aluiziotomazelli/washing-machine/docs/eletrical.webp

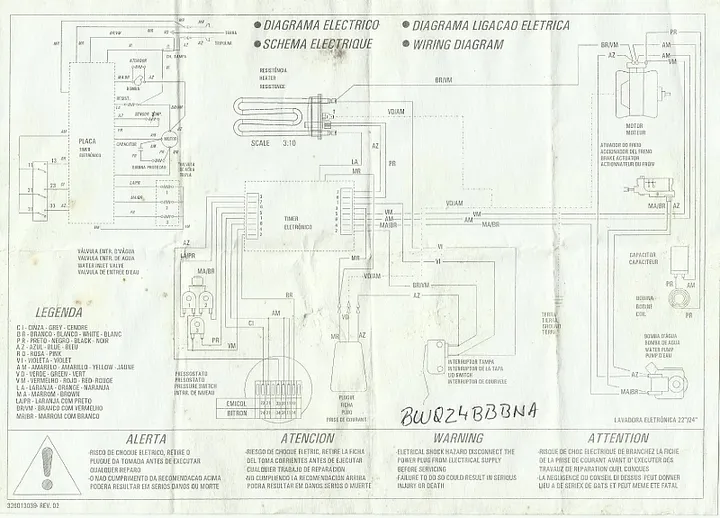
docs/eletrical.webp
