aluiziotomazelli/washing-machine/docs/board-03.webp

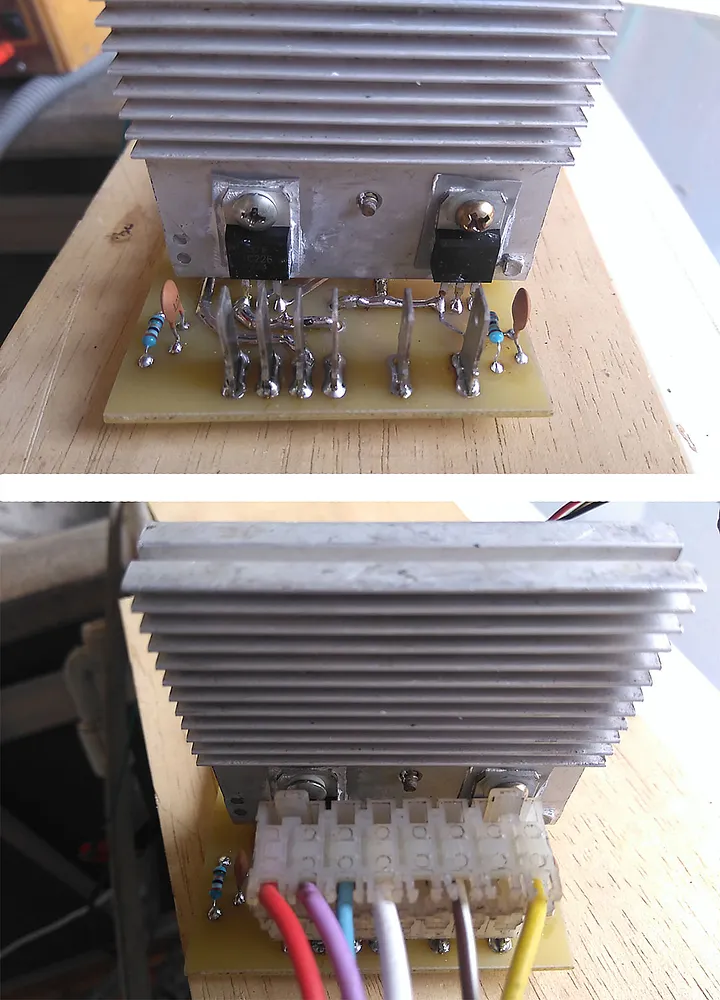
docs/board-03.webp
