aluiziotomazelli/washing-machine/docs/balance_ring_analysis.md

# Hydro-Compensating Balance Ring Dynamic Tuning & Telemetry Analysis

## 1. Executive Summary & Mechanical Context

* **Appliance Under Test:** Brastemp BWQ24B (7 kg capacity top-load domestic washing machine).
* **Firmware:** Clean C++ event-driven controller running on ATmega328P.
* **Telemetry Instrumentation:** MPU-6050 3-axis MEMS accelerometer sampled at 50.0 Hz (20 ms period) on hardware I2C with on-chip 44 Hz DLPF and 200 ms rolling 3D peak-to-peak window processing.
* **Objective:** Empirically diagnose and resolve recurrent spin unbalance aborts (`UNBALANCED_LOAD`) during heavy-fabric washing cycles (e.g. wet denim jeans) by characterizing and restoring the fluid volume of the upper liquid balancer ring.

---

## 2. Problem Statement & Physics of the Balance Ring

### 2.1 The Jeans vs. Blanket Paradox

During initial spin characterization, test runs using a heavy blanket (rolled vertically along the entire drum height) generated moderate vibration without triggering safety trips or cabinet walking. However, real-world washing with wet denim jeans triggered repeated out-of-balance trips during the transition from the final acceleration sprint into high-speed spin.

This discrepancy is governed by the difference between **planar unbalance** and **dynamic conical precession (angular moment)**:

```
   DISTRIBUTED LOAD (BLANKET)                BOTTOM-HEAVY LOAD (JEANS)
      (Planar Centrifugal Force)              (Dynamic Conical Moment)

   ┌────────────────────────┐              ┌────────────────────────┐
   │ [~~~ Balance Ring ~~~] │ ◄─ Direct    │ [~~~ Balance Ring ~~~] │ ◄─ Top counterweight
   │ █                      │    alignment │                        │
   │ █                      │              │                        │    DYNAMIC
   │ █  (Extended mass      │              │       SPIN AXIS        │    CONICAL
   │ █   spans entire       │              │           ▲            │    COUPLE
   │ █   basket height)     │              │           │            │       ↺
   │ █                      │              │  █ █                   │ ◄─ Concentrated
   └──────────┬─────────────┘              └───────────┬────────────┘    mass at bottom
              │                                        │
```

1. **Planar Centrifugal Force:**
   $$F_c = m \cdot \omega^2 \cdot r$$
   When the load spans the full height of the basket, its center of mass sits near the upper rim. The liquid balance ring sits directly in this plane, allowing fluid to shift to the opposite wall and cancel the radial force.

2. **Conical Precession Couple (Moment Arm $d$):**
   $$M = F_c \times d = (m \cdot \omega^2 \cdot r) \cdot d$$
   Wet jeans compact into a dense, rigid lump at the bottom of the basket, far below the suspension pivot and the balance ring. The bottom-heavy mass exerts a tilting torque on the hanging suspension rods. If the balance ring lacks adequate fluid volume, the upper counter-torque cannot cancel the bottom moment, causing severe resonant wobble during acceleration.

### 2.2 Balance Ring Fluid Mechanics & Evaporation

The liquid balancer ring on top-load washers is a hollow annular polypropylene channel containing internal baffle chambers and a saline/water solution. Its operating principle relies on **supercritical rotation** ($\omega > \omega_n$, where $\omega_n \approx 150\text{--}250\text{ RPM}$ is the suspension natural frequency):

* Below resonance ($\omega < \omega_n$), the fluid leads the unbalance.
* Above resonance ($\omega > \omega_n$), phase lag shifts the fluid $180^\circ$ out-of-phase, directly opposing the eccentric mass.
* The internal baffles force fluid through restrictive apertures, dissipating kinetic energy as viscous shear heat.

Over 10 to 15+ years of service, micro-permeation through the polymer walls and weld joints gradually reduces fluid mass. If fluid volume drops below $\sim 40\%$, the ring cannot generate sufficient counter-torque ($m_{\text{fluid}} \cdot r \cdot \omega^2$) to stabilize heavy bottom unbalances.

Conversely, overfilling starves the ring of the void space required for fluid to concentrate entirely on the opposite side, forcing excess fluid to co-rotate on the heavy side.

---

## 3. Experimental Methodology

1. **Mechanical Preparation & Initial Volume State:**
   * A service port was drilled in the upper face of the balance ring.
   * **Baseline Fluid Level:** The absolute initial fluid volume could not be drained and weighed directly because removing the ring would require complete mechanical disassembly of the wash basket, hub, and drive transmission. However, visual and physical inspection through the drilled port confirmed that the initial resting fluid level was **below 50% of the internal ring height**.
   * Sealed incrementally using an M-threaded screw with an elastomeric O-ring.
   * A fixed eccentric test load (dry mass secured to one quadrant of the basket) was maintained across all iterations to guarantee identical initial conditions.

2. **Sprint & Cruise Firmware Profile Tuning:**
   The `SprintStep` progressive profile was revised from longer durations to tighter, shorter acceleration pulses to improve initial distribution and smooth resonance crossing:

   * **Previous Default Profile:**
     * `Sprint 1:` `{4000, 3500}` (4.0s ON / 3.5s OFF)
     * `Sprint 2:` `{5000, 3500}` (5.0s ON / 3.5s OFF)
     * `Sprint 3:` `{6000, 4000}` (6.0s ON / 4.0s OFF)
     * `Sprint 4:` `{7000, 3000}` (7.0s ON / 3.0s OFF)
   * **Tuned Balance-Ring Profile (Active):**
     * `Sprint 1:` `{3000, 2000}` (3.0s ON / 2.0s OFF)
     * `Sprint 2:` `{3500, 2500}` (3.5s ON / 2.5s OFF)
     * `Sprint 3:` `{4000, 3500}` (4.0s ON / 3.5s OFF)
     * `Sprint 4:` `{4500, 4000}` (4.5s ON / 4.0s OFF)

   * **Full Recipe Timeline:**
     * **Clutch Engagement:** $0.0\text{s} \to 5.0\text{s}$ (5.0s pump pre-drain)
     * **Sprint 1:** $5.0\text{s} \to 8.0\text{s}$ (3.0s ON) / $8.0\text{s} \to 10.0\text{s}$ (2.0s OFF)
     * **Sprint 2:** $10.0\text{s} \to 13.5\text{s}$ (3.5s ON) / $13.5\text{s} \to 16.0\text{s}$ (2.5s OFF)
     * **Sprint 3:** $16.0\text{s} \to 20.0\text{s}$ (4.0s ON) / $20.0\text{s} \to 23.5\text{s}$ (3.5s OFF)
     * **Sprint 4 (Resonance Transition):** $23.5\text{s} \to 28.0\text{s}$ (4.5s ON) / $28.0\text{s} \to 32.0\text{s}$ (4.0s OFF)
     * **Duty Cruise (High Speed):** $32.0\text{s} \to 60.0\text{s}$ (4.0s ON / 4.0s OFF periodic pulses)

3. **Telemetry Acquisition:**
   * Python recording script: [`scripts/record_telemetry.py`](../scripts/record_telemetry.py)
   * Log repository: [`logs/balance-ring/`](../logs/balance-ring/)
   * Metric: $\text{Vib} = \Delta X + \Delta Y + \Delta Z$ (LSB over 200 ms window).

---

## 4. Telemetry Datasets & Results

Eight comprehensive 50 Hz telemetry runs were recorded and archived in `logs/balance-ring/`:

| Log File | Injected Fluid | Total Samples | Mean Vibration | Peak Shock Vibration | Resonance Peak (S4 OFF) | Cruise Mean (40–60s) |
| :--- | :---: | :---: | :---: | :---: | :---: | :---: |
| [`test_00_base.csv`](../logs/balance-ring/test_00_base.csv) | **+0 mL (Base)** | 3,002 | **3,783.9 LSB** | **29,429 LSB** | **27,742 LSB** | 3,387.0 LSB |
| [`test_01_plus50ml.csv`](../logs/balance-ring/test_01_plus50ml.csv) | **+50 mL** | 3,003 | **3,076.7 LSB** | **21,983 LSB** | **9,519 LSB** | 5,050.3 LSB |
| [`test_02_plus100ml.csv`](../logs/balance-ring/test_02_plus100ml.csv) | **+100 mL** | 3,003 | **2,933.8 LSB** | **8,309 LSB** | **5,436 LSB** | 5,250.2 LSB |
| [`test_03_plus150ml.csv`](../logs/balance-ring/test_03_plus150ml.csv) | **+150 mL** | 3,002 | **2,791.9 LSB** | **8,549 LSB** | **4,376 LSB** | 5,340.1 LSB |
| [`test_04_plus200ml.csv`](../logs/balance-ring/test_04_plus200ml.csv) | **+200 mL** | 3,002 | **2,444.0 LSB** | **6,116 LSB** | **4,132 LSB** | 4,057.2 LSB |
| [`test_05_plus250ml.csv`](../logs/balance-ring/test_05_plus250ml.csv) | **+250 mL** | 3,003 | 🏆 **2,140.2 LSB** | 🏆 **5,080 LSB** | 🏆 **3,485 LSB** | 🏆 **3,774.2 LSB** |
| [`test_06_plus300ml.csv`](../logs/balance-ring/test_06_plus300ml.csv) | **+300 mL** | 3,003 | 2,069.7 LSB | 📈 **5,901 LSB** | 3,043 LSB | 📈 **4,177.3 LSB** |
| [`test_07_almost-balanced-load_plus250ml.csv`](../logs/balance-ring/test_07_almost-balanced-load_plus250ml.csv) | **+250 mL (Real Load)** | 2,651 | 🏆 **1,123.4 LSB** | 🏆 **3,884 LSB** | 🏆 **1,486 LSB** | 🏆 **2,623.1 LSB** |

---

## 5. Phase-by-Phase Comparative Breakdown

The table below details mean vibration across each discrete phase of the spin recipe from baseline to overfill:

| Recipe Phase | Time Window | Base (+0 mL) | +100 mL | +150 mL | +200 mL | +250 mL (Optimal) | +300 mL (Overfill) |
| :--- | :---: | :---: | :---: | :---: | :---: | :---: | :---: |
| **Clutch Delay** | 0.0s – 5.0s | 121.7 LSB | 159.6 LSB | 149.5 LSB | 159.7 LSB | **168.8 LSB** | 214.4 LSB |
| **Sprint 1 ON (3.0s)** | 5.0s – 8.0s | 131.1 LSB | 268.4 LSB | 270.9 LSB | 900.6 LSB | **274.1 LSB** | 216.8 LSB |
| **Sprint 1 OFF (2.0s)** | 8.0s – 10.0s | 192.8 LSB | 309.5 LSB | 351.8 LSB | 1250.2 LSB | **382.4 LSB** | 375.3 LSB |
| **Sprint 2 ON (3.5s)** | 10.0s – 13.5s | 268.2 LSB | 316.6 LSB | 302.3 LSB | 544.4 LSB | **295.9 LSB** | 236.6 LSB |
| **Sprint 2 OFF (2.5s)** | 13.5s – 16.0s | 342.9 LSB | 448.3 LSB | 375.9 LSB | 513.0 LSB | **410.0 LSB** | 417.8 LSB |
| **Sprint 3 ON (4.0s)** | 16.0s – 20.0s | 366.0 LSB | 1,827.4 LSB | 1,882.9 LSB | 1,795.8 LSB | **1,538.3 LSB** | 1,229.8 LSB |
| **Sprint 3 OFF (3.5s)** | 20.0s – 23.5s | 677.7 LSB | 1,819.3 LSB | 1,934.5 LSB | 1,947.9 LSB | **1,762.7 LSB** | 1,809.4 LSB |
| **Sprint 4 ON (4.5s)** | 23.5s – 28.0s | 3,351.9 LSB | 1,165.3 LSB | 823.1 LSB | 893.3 LSB | **757.8 LSB** | 692.4 LSB |
| **Sprint 4 OFF (Resonance)** | 28.0s – 32.0s | **15,446.2 LSB** | **3,288.9 LSB** | **1,985.5 LSB** | **2,824.9 LSB** | **2,062.1 LSB** | 1,730.9 LSB |
| **Cruise 1 ON (4.0s)** | 32.0s – 36.0s | **10,837.2 LSB** | 3,000.8 LSB | 3,494.0 LSB | 2,327.1 LSB | **2,779.3 LSB** | 1,499.0 LSB |
| **Cruise 1 OFF (4.0s)** | 36.0s – 40.0s | **8,039.3 LSB** | 5,629.7 LSB | 4,106.2 LSB | 4,410.8 LSB | **3,328.2 LSB** | 3,535.9 LSB |
| **Cruise 2 ON (4.0s)** | 40.0s – 44.0s | 2,341.5 LSB | 4,339.9 LSB | 5,429.7 LSB | 3,389.0 LSB | **3,558.5 LSB** | 3,438.0 LSB |
| **Cruise 2 OFF (4.0s)** | 44.0s – 48.0s | 1,484.0 LSB | 6,360.9 LSB | 4,953.8 LSB | 4,909.8 LSB | **3,818.8 LSB** | 4,200.5 LSB |
| **Cruise 3 ON (4.0s)** | 48.0s – 52.0s | 2,544.4 LSB | 4,474.6 LSB | 5,508.5 LSB | 3,505.9 LSB | **3,695.8 LSB** | 3,624.5 LSB |
| **Cruise 3 OFF (4.0s)** | 52.0s – 56.0s | 5,179.7 LSB | 6,446.0 LSB | 5,144.3 LSB | 4,959.5 LSB | **3,927.7 LSB** | **4,605.7 LSB** |
| **Cruise 4 ON (4.0s)** | 56.0s – 60.0s | 5,389.1 LSB | 4,624.4 LSB | 5,685.8 LSB | 3,520.8 LSB | **3,881.8 LSB** | **3,749.5 LSB** |

---

## 6. Key Analysis & The Convex Inflection Point

```
 Peak Vibration vs. Injected Fluid Volume (Convex U-Curve)

  30k ──┐  Base (29,429 LSB)
        │   █
  25k ──┼───█─────────────────────────────────────── Critical Trip Limit (11,000 LSB)
        │   █     +50mL (21,983 LSB)
  20k ──┼───█──────█────────────────────────────────
        │   █      █
  15k ──┼───█──────█────────────────────────────────
        │   █      █
  10k ──┼───█──────█──────+100mL     +150mL
        │   █      █      (8,309)   (8,549)             +300mL (5,901)
   5k ──┼───█──────█────────█─────────█───────+200mL      ▲ (Uptick)
        │   █      █        █         █       (6,116)  +250mL █
    0 ──┴───┴──────┴────────┴─────────┴─────────█─────────█───┴────
          +0mL   +50mL   +100mL    +150mL    +200mL   +250mL +300mL
                                             [--- SWEET SPOT ---]
```

1. **Baseline Failure (0 mL):**
   * The depleted balance ring generated a peak shock of **29,429 LSB** (nearly $3\times$ the firmware safety trip threshold of 11,000 LSB).
   * Sustained resonance oscillation during Sprint 4 OFF and Cruise 1 lasted over 12 seconds with average vibration exceeding 15,000 LSB.

2. **Linear Recovery Zone (+50 mL to +150 mL):**
   * **+50 mL:** Reduced peak shock to 21,983 LSB (-25.3%). Rapid damping appeared immediately upon motor de-energization.
   * **+100 mL:** Peak dropped to 8,309 LSB (-71.8%). For the first time, vibration remained below the firmware warning threshold (8,500 LSB) throughout the entire run.
   * **+150 mL:** Resonance peak in Sprint 4 OFF dropped from 15,446 LSB down to 1,985 LSB (-87.1%).

3. **Optimal Minimum (+200 mL to +250 mL):**
   * **+200 mL:** Global peak dropped to 6,116 LSB; steady-state cruise dropped to 4,057 LSB.
   * **+250 mL (Global Minimum):** Achieved the lowest peak shock across the entire experiment at **5,080 LSB** (-82.7% reduction vs. baseline) and the lowest overall average at **2,140.2 LSB**.

4. **Inflection / Overfill Zone (+300 mL):**
   * At +300 mL, peak vibration reversed direction and climbed back up to **5,901 LSB** (+16.2% increase vs. +250 mL).
   * High-speed cruise vibration (52s–60s) rose from 3,927 LSB to 4,605 LSB due to fluid co-rotation on the eccentric quadrant.

---

## 7. Real-World Distributed Load Verification (`test_07`)

Following the identification of the +250 mL optimum, the balance ring was sealed with an M-screw and elastomeric O-ring. A realistic asymmetric load (~750g on one basket side vs. ~500g on the opposite side, net unbalance ~250g) was tested:

| Metric | Baseline (+0 mL, Unbalanced) | Test 05 (+250 mL, Single-Sided) | **Test 07 (+250 mL, Distributed Load)** | **Empty Tub Reference** |
| :--- | :---: | :---: | :---: | :---: |
| **Peak Shock Vibration** | 29,429 LSB | 5,080 LSB | 🏆 **3,884 LSB** | **3,729 LSB** |
| **Mean Vibration (0–60s)** | 3,783.9 LSB | 2,140.2 LSB | 🏆 **1,123.4 LSB** | **1,365.6 LSB** |
| **Sprint 4 Resonance Peak** | 27,742 LSB | 3,485 LSB | 🏆 **1,486 LSB** | — |
| **Cruise Steady-State Mean** | 3,387.0 LSB | 3,774.2 LSB | 🏆 **2,623.1 LSB** | — |

* **Key Result:** Under real washing conditions with +250 mL injected, the machine exhibited an overall mean vibration of **1,123.4 LSB** and a peak of **3,884 LSB**, performing virtually identically to an empty drum (1,365.6 LSB mean / 3,729 LSB peak).
* **Safety Margin:** Operating at 3,884 LSB provides a **$\approx 280\%$ safety margin** below the 11,000 LSB firmware trip threshold, eliminating spurious unbalance trips.

---

## 8. Physical Calibration Reference (Brastemp BWQ24B)

* **Calibrated Added Volume:** **+250 mL** (via syringe injection).
* **Internal Water Level:** Direct inspection confirmed that with the +250 mL replenishment, the resting water column occupies approximately **75% of the total internal height** of the annular ring channel.
* **Hermetic Seal:** Mechanical sealing completed using an M-threaded screw with an elastomeric O-ring.
* **Firmware Configuration:** Out-of-balance trip threshold safely maintained at **11,000 LSB** (sustained $\ge 1.0\text{s}$) / **14,000 LSB** (immediate shock), ensuring complete reliability under heavy residential wash loads without nuisance trips.
