aluiziotomazelli/washing-machine/docs/board-01.webp

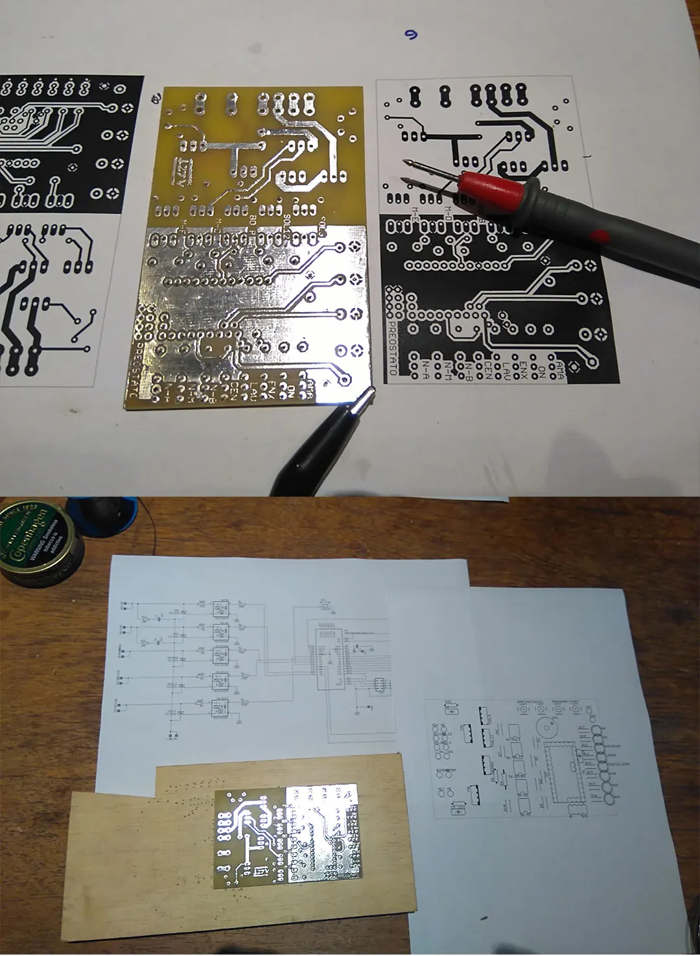
docs/board-01.webp
