aluiziotomazelli/washing-machine/docs/board-02.webp

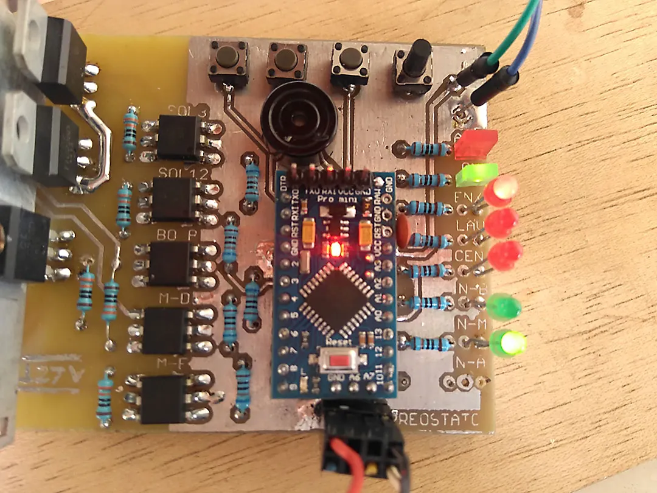
docs/board-02.webp
