aluiziotomazelli/washing-machine/docs/board-04.webp

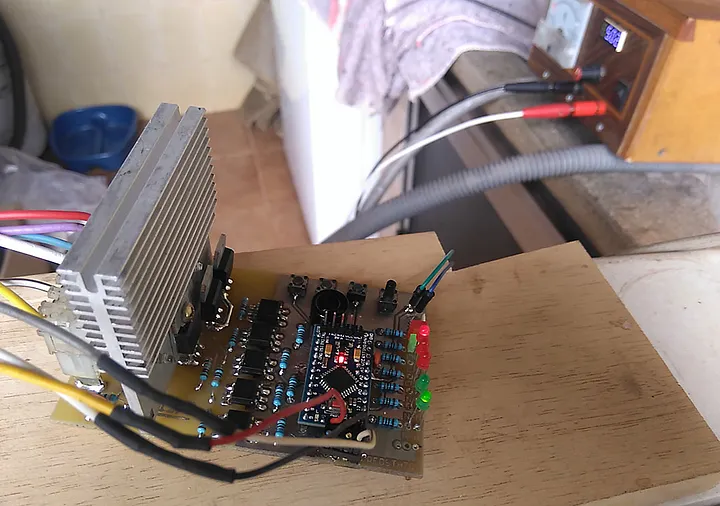
docs/board-04.webp
