aluiziotomazelli/washing-machine/docs/box.webp

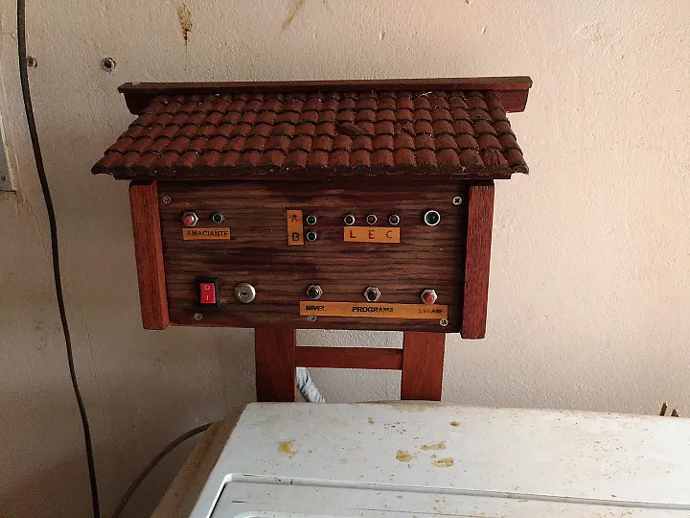
docs/box.webp
