aluiziotomazelli/washing-machine/docs/pressostat.webp

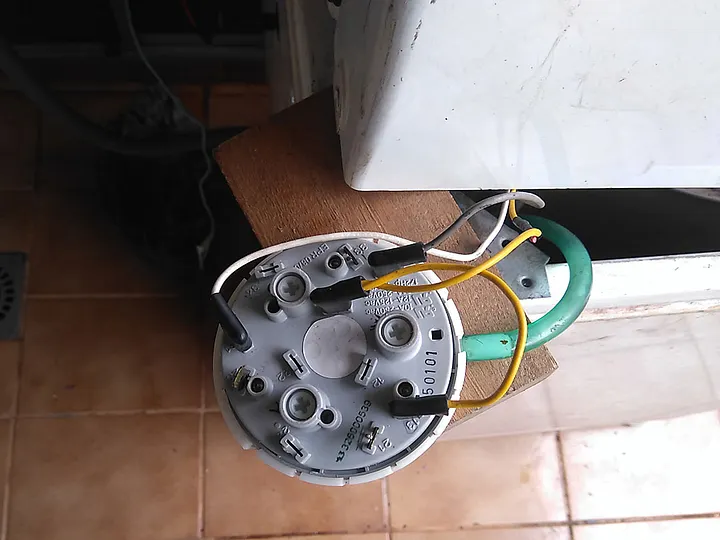
docs/pressostat.webp
