aluiziotomazelli/washing-machine/docs/schematic-01.webp

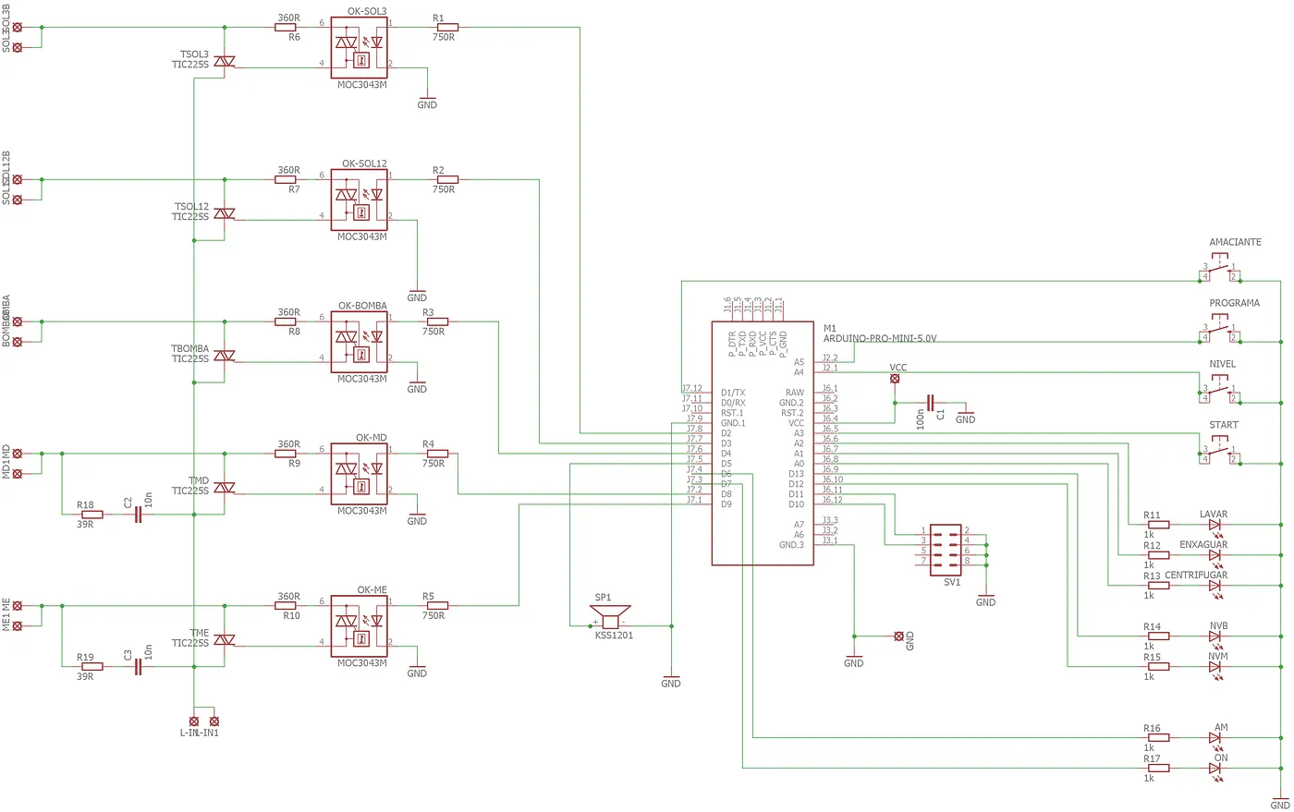
docs/schematic-01.webp
