aluiziotomazelli/washing-machine/logs/balance-ring/test_00_base.csv

elapsed_ms | elapsed_s | x | y | z | vib
0 | 0.000 | -7526 | -377 | -1177 | 0
16 | 0.016 | -7519 | -394 | -1208 | 0
47 | 0.048 | -7515 | -392 | -1182 | 0
63 | 0.064 | -7542 | -377 | -1195 | 0
79 | 0.080 | -7532 | -383 | -1185 | 0
95 | 0.096 | -7548 | -393 | -1177 | 0
127 | 0.128 | -7553 | -373 | -1174 | 0
143 | 0.144 | -7513 | -402 | -1199 | 0
159 | 0.160 | -7523 | -383 | -1161 | 0
175 | 0.176 | -7537 | -377 | -1163 | 116
207 | 0.208 | -7511 | -398 | -1164 | 116
223 | 0.223 | -7511 | -374 | -1213 | 116
239 | 0.239 | -7533 | -371 | -1189 | 116
255 | 0.255 | -7516 | -374 | -1178 | 116
287 | 0.287 | -7516 | -386 | -1183 | 116
303 | 0.303 | -7527 | -400 | -1211 | 116
319 | 0.319 | -7510 | -388 | -1172 | 116
335 | 0.335 | -7549 | -381 | -1167 | 116
367 | 0.367 | -7536 | -373 | -1200 | 116
382 | 0.383 | -7527 | -360 | -1180 | 128
398 | 0.398 | -7504 | -378 | -1168 | 128
414 | 0.415 | -7517 | -396 | -1213 | 128
446 | 0.447 | -7519 | -382 | -1193 | 128
462 | 0.463 | -7542 | -373 | -1199 | 128
478 | 0.479 | -7526 | -375 | -1211 | 128
494 | 0.495 | -7534 | -398 | -1240 | 128
526 | 0.526 | -7526 | -393 | -1204 | 128
541 | 0.542 | -7516 | -378 | -1182 | 128
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
