aluiziotomazelli/washing-machine/logs/balance-ring/test_01_plus50ml.csv

elapsed_ms | elapsed_s | x | y | z | vib
0 | 0.000 | -7549 | -375 | -1181 | 0
15 | 0.016 | -7514 | -370 | -1181 | 0
31 | 0.032 | -7526 | -379 | -1184 | 0
63 | 0.064 | -7519 | -384 | -1193 | 0
79 | 0.080 | -7520 | -372 | -1207 | 0
95 | 0.096 | -7522 | -391 | -1200 | 0
111 | 0.112 | -7546 | -381 | -1207 | 0
143 | 0.143 | -7517 | -370 | -1195 | 0
159 | 0.159 | -7517 | -367 | -1183 | 0
175 | 0.175 | -7531 | -369 | -1182 | 85
191 | 0.191 | -7501 | -366 | -1200 | 85
223 | 0.223 | -7522 | -367 | -1221 | 85
239 | 0.239 | -7516 | -377 | -1223 | 85
255 | 0.255 | -7546 | -365 | -1190 | 85
271 | 0.271 | -7552 | -386 | -1203 | 85
302 | 0.303 | -7505 | -361 | -1204 | 85
318 | 0.319 | -7508 | -389 | -1202 | 85
334 | 0.335 | -7514 | -364 | -1201 | 85
366 | 0.366 | -7520 | -362 | -1211 | 85
382 | 0.383 | -7563 | -396 | -1175 | 145
398 | 0.399 | -7533 | -372 | -1154 | 145
414 | 0.415 | -7531 | -364 | -1173 | 145
446 | 0.446 | -7510 | -375 | -1186 | 145
462 | 0.462 | -7531 | -362 | -1210 | 145
478 | 0.478 | -7533 | -372 | -1190 | 145
494 | 0.494 | -7531 | -349 | -1198 | 145
525 | 0.526 | -7540 | -386 | -1185 | 145
542 | 0.542 | -7522 | -377 | -1185 | 145
558 | 0.558 | -7503 | -350 | -1195 | 145
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
