aluiziotomazelli/washing-machine/logs/balance-ring/test_02_plus100ml.csv

elapsed_ms | elapsed_s | x | y | z | vib
0 | 0.000 | -7522 | -398 | -1192 | 0
15 | 0.016 | -7525 | -379 | -1191 | 0
31 | 0.032 | -7535 | -391 | -1175 | 0
63 | 0.063 | -7512 | -386 | -1190 | 0
79 | 0.080 | -7533 | -369 | -1175 | 0
95 | 0.096 | -7527 | -365 | -1224 | 0
111 | 0.112 | -7521 | -396 | -1202 | 0
142 | 0.143 | -7510 | -392 | -1227 | 0
158 | 0.159 | -7527 | -392 | -1199 | 0
175 | 0.175 | -7525 | -373 | -1195 | 110
191 | 0.191 | -7516 | -380 | -1169 | 110
223 | 0.223 | -7528 | -364 | -1179 | 110
239 | 0.239 | -7512 | -396 | -1197 | 110
255 | 0.255 | -7520 | -386 | -1220 | 110
271 | 0.271 | -7516 | -365 | -1191 | 110
302 | 0.303 | -7503 | -374 | -1206 | 110
318 | 0.319 | -7539 | -391 | -1217 | 110
334 | 0.335 | -7507 | -362 | -1199 | 110
350 | 0.351 | -7512 | -383 | -1184 | 110
382 | 0.383 | -7527 | -396 | -1202 | 121
398 | 0.399 | -7535 | -375 | -1210 | 121
414 | 0.415 | -7519 | -374 | -1217 | 121
430 | 0.431 | -7502 | -384 | -1172 | 121
462 | 0.462 | -7531 | -398 | -1201 | 121
478 | 0.478 | -7524 | -372 | -1190 | 121
494 | 0.494 | -7525 | -395 | -1183 | 121
510 | 0.510 | -7531 | -360 | -1207 | 121
542 | 0.542 | -7498 | -368 | -1191 | 121
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
