aluiziotomazelli/washing-machine/logs/balance-ring/test_03_plus150ml.csv

elapsed_ms | elapsed_s | x | y | z | vib
0 | 0.000 | -7532 | -374 | -1195 | 0
31 | 0.032 | -7528 | -375 | -1223 | 0
47 | 0.048 | -7521 | -372 | -1195 | 0
63 | 0.064 | -7524 | -391 | -1218 | 0
79 | 0.080 | -7506 | -393 | -1174 | 0
111 | 0.111 | -7509 | -383 | -1239 | 0
127 | 0.127 | -7535 | -366 | -1206 | 0
143 | 0.143 | -7550 | -369 | -1162 | 0
159 | 0.159 | -7528 | -394 | -1176 | 0
191 | 0.191 | -7540 | -392 | -1168 | 149
207 | 0.207 | -7520 | -383 | -1187 | 149
223 | 0.223 | -7518 | -370 | -1228 | 149
239 | 0.239 | -7527 | -360 | -1209 | 149
271 | 0.271 | -7495 | -388 | -1168 | 149
287 | 0.287 | -7526 | -363 | -1211 | 149
302 | 0.303 | -7509 | -380 | -1243 | 149
318 | 0.319 | -7537 | -390 | -1227 | 149
350 | 0.351 | -7520 | -386 | -1202 | 149
366 | 0.367 | -7502 | -382 | -1177 | 149
382 | 0.383 | -7499 | -352 | -1189 | 155
398 | 0.399 | -7529 | -368 | -1166 | 155
430 | 0.431 | -7532 | -400 | -1192 | 155
446 | 0.446 | -7514 | -361 | -1186 | 155
462 | 0.462 | -7522 | -388 | -1201 | 155
478 | 0.478 | -7515 | -378 | -1209 | 155
509 | 0.510 | -7511 | -414 | -1150 | 155
526 | 0.526 | -7526 | -381 | -1203 | 155
542 | 0.542 | -7527 | -380 | -1195 | 155
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
