aluiziotomazelli/washing-machine/logs/balance-ring/test_04_plus200ml.csv

elapsed_ms | elapsed_s | x | y | z | vib
0 | 0.000 | -7536 | -373 | -1192 | 0
15 | 0.016 | -7516 | -397 | -1246 | 0
47 | 0.048 | -7508 | -377 | -1234 | 0
63 | 0.064 | -7536 | -378 | -1196 | 0
79 | 0.080 | -7526 | -390 | -1183 | 0
95 | 0.096 | -7537 | -373 | -1200 | 0
127 | 0.127 | -7526 | -380 | -1207 | 0
143 | 0.143 | -7518 | -382 | -1179 | 0
159 | 0.159 | -7504 | -382 | -1166 | 0
175 | 0.175 | -7524 | -368 | -1232 | 142
207 | 0.207 | -7520 | -378 | -1221 | 142
223 | 0.223 | -7510 | -383 | -1226 | 142
239 | 0.239 | -7518 | -383 | -1193 | 142
255 | 0.255 | -7536 | -376 | -1204 | 142
287 | 0.287 | -7514 | -382 | -1183 | 142
302 | 0.303 | -7540 | -396 | -1245 | 142
318 | 0.319 | -7505 | -373 | -1214 | 142
334 | 0.335 | -7530 | -361 | -1172 | 142
366 | 0.367 | -7547 | -370 | -1241 | 142
382 | 0.383 | -7520 | -389 | -1234 | 150
398 | 0.399 | -7544 | -397 | -1188 | 150
414 | 0.415 | -7496 | -376 | -1187 | 150
446 | 0.446 | -7544 | -376 | -1196 | 150
462 | 0.462 | -7521 | -370 | -1204 | 150
478 | 0.478 | -7529 | -402 | -1214 | 150
494 | 0.494 | -7513 | -368 | -1194 | 150
526 | 0.526 | -7513 | -379 | -1199 | 150
542 | 0.542 | -7524 | -379 | -1190 | 150
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
