aluiziotomazelli/washing-machine/logs/balance-ring/test_05_plus250ml.csv

elapsed_ms | elapsed_s | x | y | z | vib
0 | 0.000 | -7516 | -405 | -1237 | 0
16 | 0.016 | -7514 | -391 | -1205 | 0
32 | 0.032 | -7515 | -407 | -1202 | 0
63 | 0.064 | -7521 | -382 | -1220 | 0
79 | 0.080 | -7507 | -389 | -1203 | 0
95 | 0.096 | -7509 | -399 | -1229 | 0
111 | 0.112 | -7514 | -387 | -1248 | 0
143 | 0.143 | -7522 | -416 | -1211 | 0
159 | 0.160 | -7520 | -390 | -1251 | 0
175 | 0.176 | -7520 | -392 | -1228 | 98
191 | 0.192 | -7521 | -395 | -1197 | 98
223 | 0.223 | -7522 | -389 | -1243 | 98
239 | 0.239 | -7496 | -369 | -1232 | 98
255 | 0.255 | -7531 | -397 | -1203 | 98
271 | 0.271 | -7540 | -414 | -1227 | 98
302 | 0.303 | -7539 | -431 | -1214 | 98
319 | 0.319 | -7499 | -389 | -1241 | 98
335 | 0.335 | -7548 | -407 | -1227 | 98
351 | 0.351 | -7513 | -414 | -1190 | 98
382 | 0.383 | -7515 | -403 | -1226 | 167
398 | 0.399 | -7499 | -388 | -1234 | 167
415 | 0.415 | -7542 | -395 | -1209 | 167
430 | 0.431 | -7518 | -393 | -1225 | 167
462 | 0.463 | -7502 | -398 | -1228 | 167
478 | 0.479 | -7511 | -404 | -1234 | 167
494 | 0.495 | -7515 | -386 | -1242 | 167
510 | 0.511 | -7520 | -391 | -1231 | 167
542 | 0.542 | -7535 | -382 | -1253 | 167
558 | 0.558 | -7518 | -416 | -1250 | 167
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
