aluiziotomazelli/washing-machine/washing-machine.ino

#include <Arduino.h>

#include "src/hal/pinout.hpp"
#include "src/hal/arduino/arduino_gpio_hal.hpp"
#include "src/hal/arduino/arduino_timer_hal.hpp"
#include "src/hal/arduino/arduino_watchdog_hal.hpp"
#include "src/hal/digital_output.hpp"
#include "src/hal/reversible_motor.hpp"
#include "src/hal/pressure_switch_sensor.hpp"
#include "src/ui/button.hpp"
#include "src/ui/buzzer.hpp"
#include "src/hal/ws2812_strip.hpp"
#include "src/ui/interfaces/i_button.hpp"
#include "src/ui/strip_led_panel.hpp"
#include "src/controllers/fill_controller.hpp"
#include "src/controllers/agitator.hpp"
#include "src/controllers/drain_controller.hpp"
#include "src/controllers/spin_controller.hpp"
#include "src/controllers/vibration_monitor.hpp"
#include "src/fsm/wash_cycle_coordinator.hpp"
#include "src/ui/diagnostic_controller.hpp"
#include "src/ui/panel_controller.hpp"
#include "src/hal/arduino/arduino_i2c_hal.hpp"
#include "src/hal/arduino/arduino_eeprom_hal.hpp"
#include "src/hal/mpu6050.hpp"
#include "src/persistence/cycle_persistence_manager.hpp"

// Hardware Abstraction Layer instances:
static hal::ArduinoGpioHAL gpio_hal;
static hal::ArduinoTimerHAL timer_hal;
static hal::ArduinoWatchdogHAL watchdog_hal;
static hal::ArduinoI2cHAL i2c_hal;
static hal::ArduinoEepromHAL eeprom_hal;

// Persistence Manager:
static persistence::CyclePersistenceManager persistence_mgr(eeprom_hal);

// Accelerometer Sensor & Vibration Monitor:
static hal::Mpu6050 accel_sensor(i2c_hal);
static controllers::VibrationMonitor vib_monitor(accel_sensor, timer_hal);

// UI Hardware Components:
static ui::ButtonConfig btn_cfg{
    true, // active_low
    true, // enable_internal_pull
    20,   // debounce_press_ms
    20,   // debounce_release_ms
    100,  // double_click_ms
    800,  // long_click_ms
    1600, // very_long_click_ms
    6000  // timeout_ms
};

static ui::Button btn_start(gpio_hal, timer_hal, config::k_btn_start_pin, btn_cfg);
static ui::Button btn_program(gpio_hal, timer_hal, config::k_btn_program_pin, btn_cfg);
static ui::Button btn_level(gpio_hal, timer_hal, config::k_btn_level_pin, btn_cfg);
static ui::Button btn_softener(gpio_hal, timer_hal, config::k_btn_softener_pin, btn_cfg);

static hal::PressureSwitchConfig pressure_switch_cfg{
    {config::k_pressure_switch_low_pin, hal::ContactType::NORMALLY_CLOSED},
    {config::k_pressure_switch_med_pin, hal::ContactType::NORMALLY_OPEN},
    {config::k_pressure_switch_high_pin, hal::ContactType::NORMALLY_OPEN}};
static hal::PressureSwitchSensor water_level_sensor(gpio_hal, timer_hal, pressure_switch_cfg);

static ui::Buzzer buzzer(gpio_hal, timer_hal, config::k_buzzer_pin, 3000);

// Addressable RGB LED Strip Panel (9 Pixels WS2812B)
static hal::Ws2812Strip led_strip(config::k_led_strip_pin, 9);
static ui::StripLedPanel led_panel(led_strip, timer_hal);

// Actuators:
static hal::DigitalOutput valve_main(gpio_hal, config::k_valve_main_pin);
static hal::DigitalOutput valve_softener(gpio_hal, config::k_valve_softener_pin);
static hal::DigitalOutput drain_pump(gpio_hal, config::k_drain_pump_pin);
static hal::ReversibleMotor motor(gpio_hal, timer_hal, config::k_motor_cw_pin, config::k_motor_ccw_pin);

// Atomic Process Controllers:
static controllers::FillController fill_ctrl(timer_hal, valve_main, valve_softener, water_level_sensor);
static controllers::Agitator agitator(timer_hal, motor);
static controllers::DrainController drain_ctrl(timer_hal, drain_pump, water_level_sensor);
static controllers::SpinController spin_ctrl(timer_hal, drain_pump, motor, controllers::SpinConfig{}, &vib_monitor);

// Central Cycle Coordinator (FSM):
static fsm::WashCycleCoordinator
    coordinator(timer_hal, fill_ctrl, agitator, drain_ctrl, spin_ctrl, fsm::CoordinatorConfig{}, &persistence_mgr);

// Diagnostic Controller:
static ui::DiagnosticController diag_ctrl(
    btn_start,
    btn_program,
    led_panel,
    buzzer,
    water_level_sensor,
    valve_main,
    valve_softener,
    drain_pump,
    motor,
    timer_hal,
    &vib_monitor);

// UI Panel Controller:
static ui::PanelController panel_ctrl(
    btn_start,
    btn_program,
    btn_level,
    btn_softener,
    led_panel,
    buzzer,
    coordinator,
    &diag_ctrl,
    &timer_hal,
    &persistence_mgr);

void setup()
{
    // Check if recovery from hardware watchdog reset occurred
    bool recovered_from_wdt = watchdog_hal.was_reset_by_watchdog();

    // Initialize Hardware Peripherals
    btn_start.init();
    btn_program.init();
    btn_level.init();
    btn_softener.init();

    water_level_sensor.init();
    buzzer.init();
    led_panel.init();

    hal::DigitalOutput::init_all();
    motor.init();

    // Initialize MPU-6050 Accelerometer & Vibration Monitor
    accel_sensor.init();
    vib_monitor.init();

    // Arm Hardware Watchdog (2-second timeout protection against MCU freeze)
    watchdog_hal.enable(hal::WatchdogTimeout::TIMEOUT_2S);

    // Initialize Coordinator & UI Panel Presentation
    coordinator.init();

    // Check for power-loss recovery snapshot from EEPROM
    persistence::CycleSnapshot snapshot{};
    bool has_saved_snapshot = persistence_mgr.load_latest(snapshot);

    if (has_saved_snapshot && snapshot.is_running) {
        // Automatic AC power-loss recovery (only beep if actively running, silent if was paused)
        if (!snapshot.is_paused) {
            buzzer.play_pattern(ui::BuzzerPattern::DOUBLE_BEEP);
        }
        coordinator.resume_interrupted_cycle(snapshot);
        panel_ctrl.init();
    }
    else {
        panel_ctrl.init();
        // Audible alert if reboot was caused by Watchdog freeze recovery
        if (recovered_from_wdt) {
            buzzer.play_pattern(ui::BuzzerPattern::DOUBLE_BEEP);
            buzzer.play_pattern(ui::BuzzerPattern::DOUBLE_BEEP);
        }
    }
}

void loop()
{
    // Hardware sensor & driver periodic processing
    water_level_sensor.update();
    motor.update();

    // Process & UI coordination
    if (!diag_ctrl.is_active()) {
        coordinator.update();
    }
    panel_ctrl.update();

    // Pet / kick hardware watchdog to prevent timeout reset
    watchdog_hal.kick();
}
