aluiziotomazelli/washing-machine/test/test_spin_controller.cpp

#include <gtest/gtest.h>
#include <gmock/gmock.h>
#include "mocks/mock_timer_hal.hpp"
#include "mocks/mock_digital_output.hpp"
#include "mocks/mock_reversible_motor.hpp"
#include "mocks/mock_vibration_monitor.hpp"
#include "controllers/spin_controller.hpp"

using ::testing::NiceMock;
using ::testing::Return;
using ::testing::Invoke;
using ::testing::AtLeast;

class SpinControllerTest : public ::testing::Test {
protected:
    NiceMock<mocks::MockTimerHAL> mock_timer;
    NiceMock<mocks::MockDigitalOutput> mock_drain_pump;
    NiceMock<mocks::MockReversibleMotor> mock_motor;

    uint32_t simulated_time_ms{0};

    // Fast timings for unit tests:
    static constexpr controllers::SprintStep test_sprints[] = {
        { 4000, 3500 },
        { 5000, 3500 },
        { 6000, 4000 },
        { 7000, 3000 }
    };

    controllers::SpinConfig config{
        1000, // 1s clutch engage
        1000, // 1s duty on
        1000, // 1s duty off
        2000, // 2s coast down
        test_sprints,
        4
    };

    controllers::SpinController spin_ctrl{
        mock_timer,
        mock_drain_pump,
        mock_motor,
        config
    };

    void SetUp() override
    {
        simulated_time_ms = 0;
        ON_CALL(mock_timer, get_time_ms()).WillByDefault(Invoke([this]() {
            return simulated_time_ms;
        }));
    }
    void step_through_sprints()
    {
        simulated_time_ms += 1000; spin_ctrl.update(); // Clutch (1000ms in test config)
        simulated_time_ms += 4000; spin_ctrl.update(); // Sprint 1 on (4000ms)
        simulated_time_ms += 3500; spin_ctrl.update(); // Sprint 1 off (3500ms)
        simulated_time_ms += 5000; spin_ctrl.update(); // Sprint 2 on (5000ms)
        simulated_time_ms += 3500; spin_ctrl.update(); // Sprint 2 off (3500ms)
        simulated_time_ms += 6000; spin_ctrl.update(); // Sprint 3 on (6000ms)
        simulated_time_ms += 4000; spin_ctrl.update(); // Sprint 3 off (4000ms)
        simulated_time_ms += 7000; spin_ctrl.update(); // Sprint 4 on (7000ms)
        simulated_time_ms += 3000; spin_ctrl.update(); // Sprint 4 off (3000ms) -> Duty Run!
    }
};

TEST_F(SpinControllerTest, StartsClutchEngagementAndTurnsPumpOn)
{
    EXPECT_CALL(mock_drain_pump, turn_on()).Times(1);
    EXPECT_CALL(mock_motor, stop()).Times(1);

    spin_ctrl.start(domain::WaterLevel::LOW_LEVEL, 60);
    EXPECT_TRUE(spin_ctrl.is_active());
    EXPECT_EQ(spin_ctrl.get_sub_phase(), controllers::SpinSubPhase::CLUTCH_ENGAGE);
}

TEST_F(SpinControllerTest, TransitionsFromClutchToFirstSprintAfterDelay)
{
    spin_ctrl.start(domain::WaterLevel::LOW_LEVEL, 60);

    // 500ms into 1000ms clutch delay -> still in clutch engage
    simulated_time_ms = 500;
    spin_ctrl.update();
    EXPECT_EQ(spin_ctrl.get_sub_phase(), controllers::SpinSubPhase::CLUTCH_ENGAGE);

    // 1000ms reached -> starts 1st sprint CW
    simulated_time_ms = 1000;
    EXPECT_CALL(mock_motor, rotate_clockwise()).Times(1);
    spin_ctrl.update();
    EXPECT_EQ(spin_ctrl.get_sub_phase(), controllers::SpinSubPhase::SPRINT_ON);
}

TEST_F(SpinControllerTest, ExecutesFourProgressiveSprintsAndTransitionsToDutyRun)
{
    EXPECT_CALL(mock_motor, rotate_clockwise()).Times(AtLeast(1));
    EXPECT_CALL(mock_motor, stop()).Times(AtLeast(1));

    spin_ctrl.start(domain::WaterLevel::LOW_LEVEL, 60);
    step_through_sprints();
    EXPECT_EQ(spin_ctrl.get_sub_phase(), controllers::SpinSubPhase::DUTY_RUN_ON);
}

TEST_F(SpinControllerTest, DutyRunAlternatesOnAndOffAndEntersCoastDown)
{
    EXPECT_CALL(mock_motor, rotate_clockwise()).Times(AtLeast(1));
    EXPECT_CALL(mock_motor, stop()).Times(AtLeast(1));

    // Start with 2s duty run duration
    spin_ctrl.start(domain::WaterLevel::LOW_LEVEL, 2);
    step_through_sprints();
    EXPECT_EQ(spin_ctrl.get_sub_phase(), controllers::SpinSubPhase::DUTY_RUN_ON);

    // 1s Duty On
    simulated_time_ms += 1000;
    spin_ctrl.update();
    EXPECT_EQ(spin_ctrl.get_sub_phase(), controllers::SpinSubPhase::DUTY_RUN_OFF);

    // 1s Duty Off -> 2s duty duration reached!
    simulated_time_ms += 1000;
    spin_ctrl.update();
    EXPECT_EQ(spin_ctrl.get_sub_phase(), controllers::SpinSubPhase::COAST_DOWN);

    // Coast down 2s -> stops pump and finishes!
    simulated_time_ms += 2000;
    EXPECT_CALL(mock_drain_pump, turn_off()).Times(1);
    spin_ctrl.update();
    EXPECT_TRUE(spin_ctrl.is_finished());
    EXPECT_FALSE(spin_ctrl.is_active());
}

TEST_F(SpinControllerTest, PauseDuringSpinKeepsPumpOnUntilCoastDownCompletes)
{
    EXPECT_CALL(mock_motor, rotate_clockwise()).Times(AtLeast(1));
    EXPECT_CALL(mock_motor, stop()).Times(AtLeast(1));

    spin_ctrl.start(domain::WaterLevel::LOW_LEVEL, 60);
    step_through_sprints();
    EXPECT_EQ(spin_ctrl.get_sub_phase(), controllers::SpinSubPhase::DUTY_RUN_ON);

    // Pause while spinning
    spin_ctrl.pause();
    EXPECT_EQ(spin_ctrl.get_sub_phase(), controllers::SpinSubPhase::PAUSE_COASTING);

    // 1s into coast-down: pump still ON, motor stopped
    simulated_time_ms += 1000;
    spin_ctrl.update();
    EXPECT_EQ(spin_ctrl.get_sub_phase(), controllers::SpinSubPhase::PAUSE_COASTING);

    // 2s coast-down finishes: pump turns off and officially pauses
    simulated_time_ms += 1000;
    EXPECT_CALL(mock_drain_pump, turn_off()).Times(1);
    spin_ctrl.update();
    EXPECT_EQ(spin_ctrl.get_sub_phase(), controllers::SpinSubPhase::PAUSED);
    EXPECT_TRUE(spin_ctrl.is_paused());

    // Resume re-engages clutch and pump safely
    EXPECT_CALL(mock_drain_pump, turn_on()).Times(1);
    spin_ctrl.resume();
    EXPECT_FALSE(spin_ctrl.is_paused());
    EXPECT_EQ(spin_ctrl.get_sub_phase(), controllers::SpinSubPhase::CLUTCH_ENGAGE);

    // After clutch engages, it restarts from Sprint 1
    simulated_time_ms += 1000;
    EXPECT_CALL(mock_motor, rotate_clockwise()).Times(1);
    spin_ctrl.update();
    EXPECT_EQ(spin_ctrl.get_sub_phase(), controllers::SpinSubPhase::SPRINT_ON);
}

TEST_F(SpinControllerTest, StopDuringSpinKeepsPumpOnUntilCoastDownCompletes)
{
    EXPECT_CALL(mock_motor, rotate_clockwise()).Times(AtLeast(1));
    EXPECT_CALL(mock_motor, stop()).Times(AtLeast(1));

    spin_ctrl.start(domain::WaterLevel::LOW_LEVEL, 60);
    step_through_sprints();

    // Soft stop
    spin_ctrl.stop();
    EXPECT_EQ(spin_ctrl.get_sub_phase(), controllers::SpinSubPhase::STOP_COASTING);

    // Finish 2s coast down
    simulated_time_ms += 2000;
    EXPECT_CALL(mock_drain_pump, turn_off()).Times(1);
    spin_ctrl.update();
    EXPECT_FALSE(spin_ctrl.is_active());
    EXPECT_TRUE(spin_ctrl.is_finished());
}

TEST_F(SpinControllerTest, EmergencyStopCutsBothImmediately)
{
    EXPECT_CALL(mock_motor, rotate_clockwise()).Times(AtLeast(1));
    EXPECT_CALL(mock_motor, stop()).Times(AtLeast(1));

    spin_ctrl.start(domain::WaterLevel::LOW_LEVEL, 60);
    step_through_sprints();

    EXPECT_CALL(mock_drain_pump, turn_off()).Times(1);
    spin_ctrl.emergency_stop();
    EXPECT_FALSE(spin_ctrl.is_active());
}

TEST_F(SpinControllerTest, NullVibrationMonitorOperatesNormally)
{
    // spin_ctrl in fixture has vibration_monitor = nullptr
    EXPECT_CALL(mock_motor, rotate_clockwise()).Times(AtLeast(1));
    EXPECT_CALL(mock_drain_pump, turn_on()).Times(1);

    spin_ctrl.start(domain::WaterLevel::LOW_LEVEL, 60);
    EXPECT_FALSE(spin_ctrl.has_error());
    EXPECT_EQ(spin_ctrl.get_unbalance_retries(), 0);

    // Update through clutch
    simulated_time_ms += 1000;
    spin_ctrl.update();
    EXPECT_EQ(spin_ctrl.get_sub_phase(), controllers::SpinSubPhase::SPRINT_ON);
    EXPECT_FALSE(spin_ctrl.has_error());
}

TEST_F(SpinControllerTest, UnbalanceTripEntersRetryCoastingAndRestartsSprintOne)
{
    mocks::MockVibrationMonitor mock_vib;
    controllers::SpinConfig retry_cfg = config;
    retry_cfg.max_unbalance_retries = 2;
    retry_cfg.coast_down_ms = 2000;

    controllers::SpinController spin_with_vib{
        mock_timer,
        mock_drain_pump,
        mock_motor,
        retry_cfg,
        &mock_vib
    };

    EXPECT_CALL(mock_vib, reset()).Times(AtLeast(1));
    EXPECT_CALL(mock_drain_pump, turn_on()).Times(1);
    spin_with_vib.start(domain::WaterLevel::LOW_LEVEL, 60);

    // Clutch engage (1000 ms) finishes and transitions to SPRINT_ON
    simulated_time_ms += 1000;
    EXPECT_CALL(mock_motor, rotate_clockwise()).Times(1);
    spin_with_vib.update();
    EXPECT_EQ(spin_with_vib.get_sub_phase(), controllers::SpinSubPhase::SPRINT_ON);

    // Normal spinning without unbalance
    simulated_time_ms += 100;
    EXPECT_CALL(mock_vib, update()).Times(1);
    EXPECT_CALL(mock_vib, is_critical_unbalance()).WillOnce(Return(false));
    spin_with_vib.update();
    EXPECT_EQ(spin_with_vib.get_sub_phase(), controllers::SpinSubPhase::SPRINT_ON);

    // Unbalance trip occurs during Sprint 1!
    simulated_time_ms += 500;
    EXPECT_CALL(mock_vib, update()).Times(1);
    EXPECT_CALL(mock_vib, is_critical_unbalance()).WillOnce(Return(true));
    EXPECT_CALL(mock_motor, stop()).Times(AtLeast(1));

    spin_with_vib.update();

    // Enters RETRY_COASTING, not error!
    EXPECT_EQ(spin_with_vib.get_sub_phase(), controllers::SpinSubPhase::RETRY_COASTING);
    EXPECT_EQ(spin_with_vib.get_unbalance_retries(), 1);
    EXPECT_FALSE(spin_with_vib.has_error());
    EXPECT_TRUE(spin_with_vib.is_active());

    // During coast down (1000ms), pump stays ON
    simulated_time_ms += 1000;
    spin_with_vib.update();
    EXPECT_EQ(spin_with_vib.get_sub_phase(), controllers::SpinSubPhase::RETRY_COASTING);

    // Coast down completes (2000ms elapsed) -> Resets monitor & restarts from CLUTCH_ENGAGE
    simulated_time_ms += 1000;
    EXPECT_CALL(mock_vib, reset()).Times(1);
    spin_with_vib.update();

    EXPECT_EQ(spin_with_vib.get_sub_phase(), controllers::SpinSubPhase::CLUTCH_ENGAGE);
    EXPECT_FALSE(spin_with_vib.has_error());
    EXPECT_EQ(spin_with_vib.get_unbalance_retries(), 1);

    // Clutch engage finishes -> transitions to SPRINT_ON
    simulated_time_ms += 1000;
    EXPECT_CALL(mock_motor, rotate_clockwise()).Times(1);
    spin_with_vib.update();
    EXPECT_EQ(spin_with_vib.get_sub_phase(), controllers::SpinSubPhase::SPRINT_ON);

    // Active in SPRINT_ON again: vibration monitor updates smoothly
    simulated_time_ms += 100;
    EXPECT_CALL(mock_vib, update()).Times(1);
    EXPECT_CALL(mock_vib, is_critical_unbalance()).WillOnce(Return(false));
    spin_with_vib.update();
    EXPECT_EQ(spin_with_vib.get_sub_phase(), controllers::SpinSubPhase::SPRINT_ON);
}

TEST_F(SpinControllerTest, UnbalanceTripExhaustingRetriesEntersStopCoastingAndFlagsError)
{
    mocks::MockVibrationMonitor mock_vib;
    controllers::SpinConfig retry_cfg = config;
    retry_cfg.max_unbalance_retries = 1; // Only 1 retry allowed
    retry_cfg.coast_down_ms = 2000;

    controllers::SpinController spin_with_vib{
        mock_timer,
        mock_drain_pump,
        mock_motor,
        retry_cfg,
        &mock_vib
    };

    EXPECT_CALL(mock_vib, reset()).Times(AtLeast(1));
    spin_with_vib.start(domain::WaterLevel::LOW_LEVEL, 60);

    // Clutch -> Sprint 1
    simulated_time_ms += 1000;
    spin_with_vib.update();

    // 1st trip: Retry 1
    simulated_time_ms += 500;
    EXPECT_CALL(mock_vib, update()).Times(1);
    EXPECT_CALL(mock_vib, is_critical_unbalance()).WillOnce(Return(true));
    spin_with_vib.update();
    EXPECT_EQ(spin_with_vib.get_sub_phase(), controllers::SpinSubPhase::RETRY_COASTING);
    EXPECT_EQ(spin_with_vib.get_unbalance_retries(), 1);
    EXPECT_FALSE(spin_with_vib.has_error());

    // Coast down expires -> Re-enters CLUTCH_ENGAGE
    simulated_time_ms += 2000;
    spin_with_vib.update();
    EXPECT_EQ(spin_with_vib.get_sub_phase(), controllers::SpinSubPhase::CLUTCH_ENGAGE);

    // Clutch expires -> enters Sprint 1 again
    simulated_time_ms += 1000;
    spin_with_vib.update();
    EXPECT_EQ(spin_with_vib.get_sub_phase(), controllers::SpinSubPhase::SPRINT_ON);

    // 2nd trip: Retries exhausted! (1 >= max 1)
    simulated_time_ms += 500;
    EXPECT_CALL(mock_vib, update()).Times(1);
    EXPECT_CALL(mock_vib, is_critical_unbalance()).WillOnce(Return(true));
    EXPECT_CALL(mock_motor, stop()).Times(AtLeast(1));
    spin_with_vib.update();

    EXPECT_EQ(spin_with_vib.get_sub_phase(), controllers::SpinSubPhase::STOP_COASTING);
    EXPECT_FALSE(spin_with_vib.has_error());
    EXPECT_TRUE(spin_with_vib.is_active());

    // Finish coast-down to safe complete stop
    simulated_time_ms += 2000;
    EXPECT_CALL(mock_drain_pump, turn_off()).Times(1);
    spin_with_vib.update();

    EXPECT_FALSE(spin_with_vib.is_active());
    EXPECT_TRUE(spin_with_vib.has_error());
}

TEST_F(SpinControllerTest, NewStartResetsRetriesAndError)
{
    mocks::MockVibrationMonitor mock_vib;
    controllers::SpinConfig retry_cfg = config;
    retry_cfg.max_unbalance_retries = 0; // Immediate error on trip
    retry_cfg.coast_down_ms = 2000;

    controllers::SpinController spin_with_vib{
        mock_timer,
        mock_drain_pump,
        mock_motor,
        retry_cfg,
        &mock_vib
    };

    EXPECT_CALL(mock_vib, reset()).Times(AtLeast(1));
    spin_with_vib.start(domain::WaterLevel::LOW_LEVEL, 60);

    // Trip immediately
    simulated_time_ms += 1000;
    spin_with_vib.update();
    EXPECT_CALL(mock_vib, update()).Times(1);
    EXPECT_CALL(mock_vib, is_critical_unbalance()).WillOnce(Return(true));
    spin_with_vib.update();
    EXPECT_EQ(spin_with_vib.get_sub_phase(), controllers::SpinSubPhase::STOP_COASTING);

    // Complete coast-down
    simulated_time_ms += 2000;
    EXPECT_CALL(mock_drain_pump, turn_off()).Times(1);
    spin_with_vib.update();
    EXPECT_TRUE(spin_with_vib.has_error());

    // Re-start clears error and retry counter
    spin_with_vib.start(domain::WaterLevel::LOW_LEVEL, 60);
    EXPECT_FALSE(spin_with_vib.has_error());
    EXPECT_EQ(spin_with_vib.get_unbalance_retries(), 0);
}

TEST_F(SpinControllerTest, ResetErrorExplicitlyClearsErrorAndRetries)
{
    mocks::MockVibrationMonitor mock_vib;
    controllers::SpinConfig retry_cfg = config;
    retry_cfg.max_unbalance_retries = 0; // Immediate error on trip
    retry_cfg.coast_down_ms = 2000;

    controllers::SpinController spin_with_vib{
        mock_timer,
        mock_drain_pump,
        mock_motor,
        retry_cfg,
        &mock_vib
    };

    EXPECT_CALL(mock_vib, reset()).Times(AtLeast(1));
    spin_with_vib.start(domain::WaterLevel::LOW_LEVEL, 60);

    // Trip into error
    simulated_time_ms += 1000;
    spin_with_vib.update();
    EXPECT_CALL(mock_vib, update()).Times(1);
    EXPECT_CALL(mock_vib, is_critical_unbalance()).WillOnce(Return(true));
    spin_with_vib.update();
    EXPECT_EQ(spin_with_vib.get_sub_phase(), controllers::SpinSubPhase::STOP_COASTING);

    // Complete coast-down
    simulated_time_ms += 2000;
    EXPECT_CALL(mock_drain_pump, turn_off()).Times(1);
    spin_with_vib.update();
    EXPECT_TRUE(spin_with_vib.has_error());

    // Explicit reset_error() clears error and monitor
    EXPECT_CALL(mock_vib, reset()).Times(1);
    spin_with_vib.reset_error();

    EXPECT_FALSE(spin_with_vib.has_error());
    EXPECT_EQ(spin_with_vib.get_unbalance_retries(), 0);
}
