aluiziotomazelli/washing-machine/src/ui/panel_controller.hpp

#pragma once

#include <stdint.h>
#include "../domain/wash_types.hpp"
#include "interfaces/i_button.hpp"
#include "interfaces/i_led_panel.hpp"
#include "interfaces/i_buzzer.hpp"
#include "../fsm/wash_cycle_coordinator.hpp"

namespace hal {
class ITimerHAL;
}

namespace persistence {
class ICyclePersistence;
}

namespace ui {

class DiagnosticController;

/**
 * @class PanelController
 * @brief User Interface controller translating button inputs into coordinator commands
 * and synchronizing LED/buzzer state with the running machine state.
 */
class PanelController {
public:
    static constexpr uint32_t k_diag_trigger_hold_ms{2500};

    PanelController(
        IButton& btn_start_pause,
        IButton& btn_program,
        IButton& btn_water_level,
        IButton& btn_softener,
        ILedPanel& led_panel,
        IBuzzer& buzzer,
        fsm::WashCycleCoordinator& coordinator,
        DiagnosticController* diag_ctrl = nullptr,
        hal::ITimerHAL* timer_hal = nullptr,
        persistence::ICyclePersistence* persistence = nullptr
    );

    void init();
    void update();

    domain::WashProgram get_selected_program() const { return selected_program_; }
    domain::WaterLevel get_selected_level() const { return selected_level_; }
    bool is_softener_enabled() const { return softener_enabled_; }
    bool is_diagnostic_active() const;

private:
    void handle_start_pause_click(ButtonClickType click);
    void handle_program_click();
    void handle_water_level_click();
    void handle_softener_click();
    void sync_state_with_coordinator();

    IButton& btn_start_pause_;
    IButton& btn_program_;
    IButton& btn_water_level_;
    IButton& btn_softener_;
    ILedPanel& led_panel_;
    IBuzzer& buzzer_;
    fsm::WashCycleCoordinator& coordinator_;
    DiagnosticController* diag_ctrl_{nullptr};
    hal::ITimerHAL* timer_hal_{nullptr};
    persistence::ICyclePersistence* persistence_{nullptr};

    domain::WashProgram selected_program_{domain::WashProgram::RINSE_ONLY};
    domain::WaterLevel selected_level_{domain::WaterLevel::LOW_LEVEL};
    bool softener_enabled_{false};
    uint32_t diag_entry_press_start_ms_{0};

    domain::MachineState prev_state_{domain::MachineState::IDLE};
    domain::WashStage prev_stage_{domain::WashStage::IDLE};
};

} // namespace ui
