aluiziotomazelli/washing-machine/test/test_discrete_led_panel.cpp

#include <gtest/gtest.h>
#include <gmock/gmock.h>
#include "mocks/mock_gpio_hal.hpp"
#include "mocks/mock_timer_hal.hpp"
#include "hal/interfaces/i_reversible_motor.hpp"
#include "ui/discrete_led_panel.hpp"

using ::testing::_;
using ::testing::Return;
using ::testing::NiceMock;
using ::testing::InSequence;

class DiscreteLedPanelTest : public ::testing::Test {
protected:
    NiceMock<mocks::MockGpioHAL> mock_gpio;
    NiceMock<mocks::MockTimerHAL> mock_timer;

    const uint8_t pin_power = 7;
    const uint8_t pin_softener = 6;
    const uint8_t pin_wash = 16;
    const uint8_t pin_rinse = 15;
    const uint8_t pin_spin = 14;
    const uint8_t pin_lvl_low = 13;
    const uint8_t pin_lvl_med = 12;

    ui::DiscreteLedPins pins{
        pin_power, pin_softener, pin_wash, pin_rinse, pin_spin,
        pin_lvl_low, pin_lvl_med, 255
    };

    ui::DiscreteLedPanel panel{mock_gpio, mock_timer, pins, true};

    void SetUp() override
    {
        panel.init();
    }
};

TEST_F(DiscreteLedPanelTest, InitializesAllPinsToOutputAndOff)
{
    EXPECT_CALL(mock_gpio, set_mode(pin_power, hal::GpioMode::MODE_OUTPUT)).Times(1);
    EXPECT_CALL(mock_gpio, set_mode(pin_softener, hal::GpioMode::MODE_OUTPUT)).Times(1);
    EXPECT_CALL(mock_gpio, set_mode(pin_wash, hal::GpioMode::MODE_OUTPUT)).Times(1);
    EXPECT_CALL(mock_gpio, set_mode(pin_rinse, hal::GpioMode::MODE_OUTPUT)).Times(1);
    EXPECT_CALL(mock_gpio, set_mode(pin_spin, hal::GpioMode::MODE_OUTPUT)).Times(1);
    EXPECT_CALL(mock_gpio, set_mode(pin_lvl_low, hal::GpioMode::MODE_OUTPUT)).Times(1);
    EXPECT_CALL(mock_gpio, set_mode(pin_lvl_med, hal::GpioMode::MODE_OUTPUT)).Times(1);

    ui::DiscreteLedPanel fresh_panel{mock_gpio, mock_timer, pins, true};
    fresh_panel.init();
}

TEST_F(DiscreteLedPanelTest, ControlsPowerAndSoftenerIndicators)
{
    // RUNNING turns power LED ON
    EXPECT_CALL(mock_gpio, set_level(pin_power, hal::GpioLevel::LEVEL_HIGH)).Times(1);
    panel.set_machine_state(domain::MachineState::RUNNING);

    // Softener controls softener LED
    EXPECT_CALL(mock_gpio, set_level(pin_softener, hal::GpioLevel::LEVEL_HIGH)).Times(1);
    panel.set_softener(true);

    // IDLE turns power LED OFF
    EXPECT_CALL(mock_gpio, set_level(pin_power, hal::GpioLevel::LEVEL_LOW)).Times(1);
    panel.set_machine_state(domain::MachineState::IDLE);

    // PAUSED blinks power LED
    EXPECT_CALL(mock_timer, get_time_ms()).WillRepeatedly(Return(1000));
    EXPECT_CALL(mock_gpio, set_level(pin_power, hal::GpioLevel::LEVEL_HIGH)).Times(1);
    panel.set_machine_state(domain::MachineState::PAUSED);

    // After 500ms -> toggles to LOW
    EXPECT_CALL(mock_timer, get_time_ms()).WillRepeatedly(Return(1500));
    EXPECT_CALL(mock_gpio, set_level(pin_power, hal::GpioLevel::LEVEL_LOW)).Times(1);
    panel.update();
}

TEST_F(DiscreteLedPanelTest, SetsProgramsDuringIdleSelection)
{
    // NORMAL_WASH: wash=HIGH (solid), rinse=LOW, spin=LOW
    EXPECT_CALL(mock_gpio, set_level(pin_wash, hal::GpioLevel::LEVEL_HIGH)).Times(1);
    EXPECT_CALL(mock_gpio, set_level(pin_rinse, hal::GpioLevel::LEVEL_LOW)).Times(1);
    EXPECT_CALL(mock_gpio, set_level(pin_spin, hal::GpioLevel::LEVEL_LOW)).Times(1);
    panel.set_program(ui::WashProgram::NORMAL_WASH);

    // RINSE_ONLY: wash=LOW, rinse=HIGH, spin=LOW
    EXPECT_CALL(mock_gpio, set_level(pin_wash, hal::GpioLevel::LEVEL_LOW)).Times(1);
    EXPECT_CALL(mock_gpio, set_level(pin_rinse, hal::GpioLevel::LEVEL_HIGH)).Times(1);
    EXPECT_CALL(mock_gpio, set_level(pin_spin, hal::GpioLevel::LEVEL_LOW)).Times(1);
    panel.set_program(ui::WashProgram::RINSE_ONLY);

    // SPIN_ONLY: wash=LOW, rinse=LOW, spin=HIGH
    EXPECT_CALL(mock_gpio, set_level(pin_wash, hal::GpioLevel::LEVEL_LOW)).Times(1);
    EXPECT_CALL(mock_gpio, set_level(pin_rinse, hal::GpioLevel::LEVEL_LOW)).Times(1);
    EXPECT_CALL(mock_gpio, set_level(pin_spin, hal::GpioLevel::LEVEL_HIGH)).Times(1);
    panel.set_program(ui::WashProgram::SPIN_ONLY);
}

TEST_F(DiscreteLedPanelTest, HeavyWashProgramBlinksWashLedNonBlocking)
{
    EXPECT_CALL(mock_timer, get_time_ms()).WillRepeatedly(Return(1000));
    EXPECT_CALL(mock_gpio, set_level(pin_wash, hal::GpioLevel::LEVEL_HIGH)).Times(1);
    EXPECT_CALL(mock_gpio, set_level(pin_rinse, hal::GpioLevel::LEVEL_LOW)).Times(1);
    EXPECT_CALL(mock_gpio, set_level(pin_spin, hal::GpioLevel::LEVEL_LOW)).Times(1);
    panel.set_program(ui::WashProgram::HEAVY_WASH);

    // Update before 500ms -> no toggle
    EXPECT_CALL(mock_timer, get_time_ms()).WillRepeatedly(Return(1200));
    panel.update();

    // Update after 500ms -> toggles to LOW
    EXPECT_CALL(mock_timer, get_time_ms()).WillRepeatedly(Return(1500));
    EXPECT_CALL(mock_gpio, set_level(pin_wash, hal::GpioLevel::LEVEL_LOW)).Times(1);
    panel.update();

    // Update after another 500ms -> toggles back to HIGH
    EXPECT_CALL(mock_timer, get_time_ms()).WillRepeatedly(Return(2000));
    EXPECT_CALL(mock_gpio, set_level(pin_wash, hal::GpioLevel::LEVEL_HIGH)).Times(1);
    panel.update();
}

TEST_F(DiscreteLedPanelTest, SetsWashStagesExclusively)
{
    // Stage WASH: wash=HIGH, rinse=LOW, spin=LOW
    EXPECT_CALL(mock_gpio, set_level(pin_wash, hal::GpioLevel::LEVEL_HIGH)).Times(1);
    EXPECT_CALL(mock_gpio, set_level(pin_rinse, hal::GpioLevel::LEVEL_LOW)).Times(1);
    EXPECT_CALL(mock_gpio, set_level(pin_spin, hal::GpioLevel::LEVEL_LOW)).Times(1);
    panel.set_stage(ui::WashStage::WASH);

    // Stage RINSE: wash=LOW, rinse=HIGH, spin=LOW
    EXPECT_CALL(mock_gpio, set_level(pin_wash, hal::GpioLevel::LEVEL_LOW)).Times(1);
    EXPECT_CALL(mock_gpio, set_level(pin_rinse, hal::GpioLevel::LEVEL_HIGH)).Times(1);
    EXPECT_CALL(mock_gpio, set_level(pin_spin, hal::GpioLevel::LEVEL_LOW)).Times(1);
    panel.set_stage(ui::WashStage::RINSE);

    // Stage SPIN: wash=LOW, rinse=LOW, spin=HIGH
    EXPECT_CALL(mock_gpio, set_level(pin_wash, hal::GpioLevel::LEVEL_LOW)).Times(1);
    EXPECT_CALL(mock_gpio, set_level(pin_rinse, hal::GpioLevel::LEVEL_LOW)).Times(1);
    EXPECT_CALL(mock_gpio, set_level(pin_spin, hal::GpioLevel::LEVEL_HIGH)).Times(1);
    panel.set_stage(ui::WashStage::SPIN);
}

TEST_F(DiscreteLedPanelTest, ControlsWaterLevelIndicators)
{
    // LOW_LEVEL: low=HIGH, med=LOW
    EXPECT_CALL(mock_gpio, set_level(pin_lvl_low, hal::GpioLevel::LEVEL_HIGH)).Times(1);
    EXPECT_CALL(mock_gpio, set_level(pin_lvl_med, hal::GpioLevel::LEVEL_LOW)).Times(1);
    panel.set_selected_level(domain::WaterLevel::LOW_LEVEL);

    // MEDIUM_LEVEL: low=LOW, med=HIGH
    EXPECT_CALL(mock_gpio, set_level(pin_lvl_low, hal::GpioLevel::LEVEL_LOW)).Times(1);
    EXPECT_CALL(mock_gpio, set_level(pin_lvl_med, hal::GpioLevel::LEVEL_HIGH)).Times(1);
    panel.set_selected_level(domain::WaterLevel::MEDIUM_LEVEL);
}

TEST_F(DiscreteLedPanelTest, FillTimeoutBlinksWaterLevelLeds)
{
    EXPECT_CALL(mock_timer, get_time_ms()).WillRepeatedly(Return(1000));
    EXPECT_CALL(mock_gpio, set_level(pin_power, hal::GpioLevel::LEVEL_LOW)).Times(1);
    EXPECT_CALL(mock_gpio, set_level(pin_wash, hal::GpioLevel::LEVEL_LOW)).Times(1);
    EXPECT_CALL(mock_gpio, set_level(pin_rinse, hal::GpioLevel::LEVEL_LOW)).Times(1);
    EXPECT_CALL(mock_gpio, set_level(pin_spin, hal::GpioLevel::LEVEL_LOW)).Times(1);
    EXPECT_CALL(mock_gpio, set_level(pin_lvl_low, hal::GpioLevel::LEVEL_HIGH)).Times(1);
    EXPECT_CALL(mock_gpio, set_level(pin_lvl_med, hal::GpioLevel::LEVEL_HIGH)).Times(1);

    panel.set_machine_state(domain::MachineState::ERROR, domain::MachineError::FILL_TIMEOUT);

    // After 500ms -> toggles level LEDs to LOW
    EXPECT_CALL(mock_timer, get_time_ms()).WillRepeatedly(Return(1500));
    EXPECT_CALL(mock_gpio, set_level(pin_lvl_low, hal::GpioLevel::LEVEL_LOW)).Times(1);
    EXPECT_CALL(mock_gpio, set_level(pin_lvl_med, hal::GpioLevel::LEVEL_LOW)).Times(1);
    panel.update();
}

TEST_F(DiscreteLedPanelTest, DrainTimeoutBlinksProgramStageLeds)
{
    EXPECT_CALL(mock_timer, get_time_ms()).WillRepeatedly(Return(1000));
    EXPECT_CALL(mock_gpio, set_level(pin_power, hal::GpioLevel::LEVEL_LOW)).Times(1);
    EXPECT_CALL(mock_gpio, set_level(pin_lvl_low, hal::GpioLevel::LEVEL_LOW)).Times(1);
    EXPECT_CALL(mock_gpio, set_level(pin_lvl_med, hal::GpioLevel::LEVEL_LOW)).Times(1);
    EXPECT_CALL(mock_gpio, set_level(pin_wash, hal::GpioLevel::LEVEL_HIGH)).Times(1);
    EXPECT_CALL(mock_gpio, set_level(pin_rinse, hal::GpioLevel::LEVEL_HIGH)).Times(1);
    EXPECT_CALL(mock_gpio, set_level(pin_spin, hal::GpioLevel::LEVEL_HIGH)).Times(1);

    panel.set_machine_state(domain::MachineState::ERROR, domain::MachineError::DRAIN_TIMEOUT);

    // After 500ms -> toggles stage LEDs to LOW
    EXPECT_CALL(mock_timer, get_time_ms()).WillRepeatedly(Return(1500));
    EXPECT_CALL(mock_gpio, set_level(pin_wash, hal::GpioLevel::LEVEL_LOW)).Times(1);
    EXPECT_CALL(mock_gpio, set_level(pin_rinse, hal::GpioLevel::LEVEL_LOW)).Times(1);
    EXPECT_CALL(mock_gpio, set_level(pin_spin, hal::GpioLevel::LEVEL_LOW)).Times(1);
    panel.update();
}

TEST_F(DiscreteLedPanelTest, UnbalancedLoadBlinksSpinLed)
{
    EXPECT_CALL(mock_timer, get_time_ms()).WillRepeatedly(Return(1000));
    EXPECT_CALL(mock_gpio, set_level(pin_power, hal::GpioLevel::LEVEL_LOW)).Times(1);
    EXPECT_CALL(mock_gpio, set_level(pin_lvl_low, hal::GpioLevel::LEVEL_LOW)).Times(1);
    EXPECT_CALL(mock_gpio, set_level(pin_lvl_med, hal::GpioLevel::LEVEL_LOW)).Times(1);
    EXPECT_CALL(mock_gpio, set_level(pin_wash, hal::GpioLevel::LEVEL_LOW)).Times(1);
    EXPECT_CALL(mock_gpio, set_level(pin_rinse, hal::GpioLevel::LEVEL_LOW)).Times(1);
    EXPECT_CALL(mock_gpio, set_level(pin_spin, hal::GpioLevel::LEVEL_HIGH)).Times(1);

    panel.set_machine_state(domain::MachineState::ERROR, domain::MachineError::UNBALANCED_LOAD);

    // After 500ms -> toggles spin LED to LOW
    EXPECT_CALL(mock_timer, get_time_ms()).WillRepeatedly(Return(1500));
    EXPECT_CALL(mock_gpio, set_level(pin_spin, hal::GpioLevel::LEVEL_LOW)).Times(1);
    panel.update();
}

TEST_F(DiscreteLedPanelTest, TurnsOffAllLedsOnPanel)
{
    EXPECT_CALL(mock_gpio, set_level(pin_power, hal::GpioLevel::LEVEL_LOW)).Times(1);
    EXPECT_CALL(mock_gpio, set_level(pin_softener, hal::GpioLevel::LEVEL_LOW)).Times(1);
    EXPECT_CALL(mock_gpio, set_level(pin_wash, hal::GpioLevel::LEVEL_LOW)).Times(1);
    EXPECT_CALL(mock_gpio, set_level(pin_rinse, hal::GpioLevel::LEVEL_LOW)).Times(1);
    EXPECT_CALL(mock_gpio, set_level(pin_spin, hal::GpioLevel::LEVEL_LOW)).Times(1);
    EXPECT_CALL(mock_gpio, set_level(pin_lvl_low, hal::GpioLevel::LEVEL_LOW)).Times(1);
    EXPECT_CALL(mock_gpio, set_level(pin_lvl_med, hal::GpioLevel::LEVEL_LOW)).Times(1);

    panel.turn_off_all();
}

TEST_F(DiscreteLedPanelTest, ShowsLevelSensorDiagnostic)
{
    // turn_off_all turns off all pins first
    EXPECT_CALL(mock_gpio, set_level(pin_power, hal::GpioLevel::LEVEL_LOW)).Times(1);
    EXPECT_CALL(mock_gpio, set_level(pin_softener, hal::GpioLevel::LEVEL_LOW)).Times(1);
    EXPECT_CALL(mock_gpio, set_level(pin_wash, hal::GpioLevel::LEVEL_LOW)).Times(1);
    EXPECT_CALL(mock_gpio, set_level(pin_rinse, hal::GpioLevel::LEVEL_LOW)).Times(1);
    EXPECT_CALL(mock_gpio, set_level(pin_spin, hal::GpioLevel::LEVEL_LOW)).Times(1);
    EXPECT_CALL(mock_gpio, set_level(pin_lvl_low, hal::GpioLevel::LEVEL_LOW)).Times(2);
    EXPECT_CALL(mock_gpio, set_level(pin_lvl_med, hal::GpioLevel::LEVEL_LOW)).Times(1);

    // Then set_selected_level(MEDIUM) sets med=HIGH and step indicator spin=HIGH
    EXPECT_CALL(mock_gpio, set_level(pin_lvl_med, hal::GpioLevel::LEVEL_HIGH)).Times(1);
    EXPECT_CALL(mock_gpio, set_level(pin_spin, hal::GpioLevel::LEVEL_HIGH)).Times(1);

    panel.show_diagnostic(domain::DiagnosticStep::LEVEL_SENSOR, static_cast<uint16_t>(domain::WaterLevel::MEDIUM_LEVEL), true);
}

TEST_F(DiscreteLedPanelTest, ShowsVibrationSensorDiagnosticWithLevelLeds)
{
    // turn_off_all turns off all pins first
    EXPECT_CALL(mock_gpio, set_level(pin_power, hal::GpioLevel::LEVEL_LOW)).Times(1);
    EXPECT_CALL(mock_gpio, set_level(pin_softener, hal::GpioLevel::LEVEL_LOW)).Times(1);
    EXPECT_CALL(mock_gpio, set_level(pin_wash, hal::GpioLevel::LEVEL_LOW)).Times(1);
    EXPECT_CALL(mock_gpio, set_level(pin_rinse, hal::GpioLevel::LEVEL_LOW)).Times(1);
    EXPECT_CALL(mock_gpio, set_level(pin_spin, hal::GpioLevel::LEVEL_LOW)).Times(1);
    EXPECT_CALL(mock_gpio, set_level(pin_lvl_low, hal::GpioLevel::LEVEL_LOW)).Times(1);
    EXPECT_CALL(mock_gpio, set_level(pin_lvl_med, hal::GpioLevel::LEVEL_LOW)).Times(1);

    // Step 2: rinse=HIGH, softener=HIGH (status_ok), vibration=6000 -> lvl_low=HIGH and lvl_med=HIGH
    EXPECT_CALL(mock_gpio, set_level(pin_rinse, hal::GpioLevel::LEVEL_HIGH)).Times(1);
    EXPECT_CALL(mock_gpio, set_level(pin_softener, hal::GpioLevel::LEVEL_HIGH)).Times(1);
    EXPECT_CALL(mock_gpio, set_level(pin_lvl_low, hal::GpioLevel::LEVEL_HIGH)).Times(1);
    EXPECT_CALL(mock_gpio, set_level(pin_lvl_med, hal::GpioLevel::LEVEL_HIGH)).Times(1);

    panel.show_diagnostic(domain::DiagnosticStep::VIBRATION_SENSOR, 6000, true);
}

TEST_F(DiscreteLedPanelTest, ShowsMainValveDiagnostic)
{
    // turn_off_all turns off all pins first
    EXPECT_CALL(mock_gpio, set_level(pin_power, hal::GpioLevel::LEVEL_LOW)).Times(1);
    EXPECT_CALL(mock_gpio, set_level(pin_softener, hal::GpioLevel::LEVEL_LOW)).Times(1);
    EXPECT_CALL(mock_gpio, set_level(pin_wash, hal::GpioLevel::LEVEL_LOW)).Times(1);
    EXPECT_CALL(mock_gpio, set_level(pin_rinse, hal::GpioLevel::LEVEL_LOW)).Times(1);
    EXPECT_CALL(mock_gpio, set_level(pin_spin, hal::GpioLevel::LEVEL_LOW)).Times(1);
    EXPECT_CALL(mock_gpio, set_level(pin_lvl_low, hal::GpioLevel::LEVEL_LOW)).Times(1);
    EXPECT_CALL(mock_gpio, set_level(pin_lvl_med, hal::GpioLevel::LEVEL_LOW)).Times(1);

    // Step 3: wash=HIGH, lvl_low=HIGH and lvl_med=HIGH when valve is ON
    EXPECT_CALL(mock_gpio, set_level(pin_wash, hal::GpioLevel::LEVEL_HIGH)).Times(1);
    EXPECT_CALL(mock_gpio, set_level(pin_lvl_low, hal::GpioLevel::LEVEL_HIGH)).Times(1);
    EXPECT_CALL(mock_gpio, set_level(pin_lvl_med, hal::GpioLevel::LEVEL_HIGH)).Times(1);

    panel.show_diagnostic(domain::DiagnosticStep::MAIN_VALVE, 1, true);
}

TEST_F(DiscreteLedPanelTest, ShowsSoftenerValveDiagnostic)
{
    // turn_off_all turns off all pins first
    EXPECT_CALL(mock_gpio, set_level(pin_power, hal::GpioLevel::LEVEL_LOW)).Times(1);
    EXPECT_CALL(mock_gpio, set_level(pin_softener, hal::GpioLevel::LEVEL_LOW)).Times(1);
    EXPECT_CALL(mock_gpio, set_level(pin_wash, hal::GpioLevel::LEVEL_LOW)).Times(1);
    EXPECT_CALL(mock_gpio, set_level(pin_rinse, hal::GpioLevel::LEVEL_LOW)).Times(1);
    EXPECT_CALL(mock_gpio, set_level(pin_spin, hal::GpioLevel::LEVEL_LOW)).Times(1);
    EXPECT_CALL(mock_gpio, set_level(pin_lvl_low, hal::GpioLevel::LEVEL_LOW)).Times(1);
    EXPECT_CALL(mock_gpio, set_level(pin_lvl_med, hal::GpioLevel::LEVEL_LOW)).Times(1);

    // Step 4: wash=HIGH, softener=HIGH when valve is ON
    EXPECT_CALL(mock_gpio, set_level(pin_wash, hal::GpioLevel::LEVEL_HIGH)).Times(1);
    EXPECT_CALL(mock_gpio, set_level(pin_softener, hal::GpioLevel::LEVEL_HIGH)).Times(1);

    panel.show_diagnostic(domain::DiagnosticStep::SOFTENER_VALVE, 1, true);
}

TEST_F(DiscreteLedPanelTest, ShowsDrainPumpDiagnostic)
{
    // turn_off_all turns off all pins first
    EXPECT_CALL(mock_gpio, set_level(pin_power, hal::GpioLevel::LEVEL_LOW)).Times(1);
    EXPECT_CALL(mock_gpio, set_level(pin_softener, hal::GpioLevel::LEVEL_LOW)).Times(1);
    EXPECT_CALL(mock_gpio, set_level(pin_wash, hal::GpioLevel::LEVEL_LOW)).Times(1);
    EXPECT_CALL(mock_gpio, set_level(pin_rinse, hal::GpioLevel::LEVEL_LOW)).Times(1);
    EXPECT_CALL(mock_gpio, set_level(pin_spin, hal::GpioLevel::LEVEL_LOW)).Times(1);
    EXPECT_CALL(mock_gpio, set_level(pin_lvl_low, hal::GpioLevel::LEVEL_LOW)).Times(2);
    EXPECT_CALL(mock_gpio, set_level(pin_lvl_med, hal::GpioLevel::LEVEL_LOW)).Times(1);

    // Step 5: spin=HIGH (step), softener=HIGH (pump ON), lvl_med=HIGH (level MEDIUM)
    EXPECT_CALL(mock_gpio, set_level(pin_lvl_med, hal::GpioLevel::LEVEL_HIGH)).Times(1);
    EXPECT_CALL(mock_gpio, set_level(pin_spin, hal::GpioLevel::LEVEL_HIGH)).Times(1);
    EXPECT_CALL(mock_gpio, set_level(pin_softener, hal::GpioLevel::LEVEL_HIGH)).Times(1);

    panel.show_diagnostic(domain::DiagnosticStep::DRAIN_PUMP, static_cast<uint16_t>(domain::WaterLevel::MEDIUM_LEVEL), true);
}

TEST_F(DiscreteLedPanelTest, ShowsMotorAgitateDiagnostic)
{
    // turn_off_all turns off all pins first
    EXPECT_CALL(mock_gpio, set_level(pin_power, hal::GpioLevel::LEVEL_LOW)).Times(1);
    EXPECT_CALL(mock_gpio, set_level(pin_softener, hal::GpioLevel::LEVEL_LOW)).Times(1);
    EXPECT_CALL(mock_gpio, set_level(pin_wash, hal::GpioLevel::LEVEL_LOW)).Times(1);
    EXPECT_CALL(mock_gpio, set_level(pin_rinse, hal::GpioLevel::LEVEL_LOW)).Times(1);
    EXPECT_CALL(mock_gpio, set_level(pin_spin, hal::GpioLevel::LEVEL_LOW)).Times(1);
    EXPECT_CALL(mock_gpio, set_level(pin_lvl_low, hal::GpioLevel::LEVEL_LOW)).Times(1);
    EXPECT_CALL(mock_gpio, set_level(pin_lvl_med, hal::GpioLevel::LEVEL_LOW)).Times(1);

    // Motor CW: wash=HIGH (step/CCW), spin=HIGH (CW)
    EXPECT_CALL(mock_gpio, set_level(pin_wash, hal::GpioLevel::LEVEL_HIGH)).Times(1);
    EXPECT_CALL(mock_gpio, set_level(pin_spin, hal::GpioLevel::LEVEL_HIGH)).Times(1);

    panel.show_diagnostic(domain::DiagnosticStep::MOTOR_AGITATE, static_cast<uint16_t>(hal::MotorState::RUNNING_CLOCKWISE), true);
}

TEST_F(DiscreteLedPanelTest, ShowsSpinTestDiagnostic)
{
    // 1. Normal running with pump & motor active: spin=HIGH, rinse=HIGH (pump), wash=HIGH (motor)
    EXPECT_CALL(mock_gpio, set_level(pin_power, hal::GpioLevel::LEVEL_LOW)).Times(1);
    EXPECT_CALL(mock_gpio, set_level(pin_softener, hal::GpioLevel::LEVEL_LOW)).Times(1);
    EXPECT_CALL(mock_gpio, set_level(pin_wash, hal::GpioLevel::LEVEL_LOW)).Times(1);
    EXPECT_CALL(mock_gpio, set_level(pin_rinse, hal::GpioLevel::LEVEL_LOW)).Times(1);
    EXPECT_CALL(mock_gpio, set_level(pin_spin, hal::GpioLevel::LEVEL_LOW)).Times(1);
    EXPECT_CALL(mock_gpio, set_level(pin_lvl_low, hal::GpioLevel::LEVEL_LOW)).Times(1);
    EXPECT_CALL(mock_gpio, set_level(pin_lvl_med, hal::GpioLevel::LEVEL_LOW)).Times(1);

    EXPECT_CALL(mock_gpio, set_level(pin_spin, hal::GpioLevel::LEVEL_HIGH)).Times(1);
    EXPECT_CALL(mock_gpio, set_level(pin_rinse, hal::GpioLevel::LEVEL_HIGH)).Times(1);
    EXPECT_CALL(mock_gpio, set_level(pin_wash, hal::GpioLevel::LEVEL_HIGH)).Times(1);

    panel.show_diagnostic(domain::DiagnosticStep::SPIN_TEST, 0x03, true);

    // 2. Vibration Tripped (status_ok = false): spin=HIGH, softener=HIGH (warning)
    EXPECT_CALL(mock_gpio, set_level(pin_power, hal::GpioLevel::LEVEL_LOW)).Times(1);
    EXPECT_CALL(mock_gpio, set_level(pin_softener, hal::GpioLevel::LEVEL_LOW)).Times(1);
    EXPECT_CALL(mock_gpio, set_level(pin_wash, hal::GpioLevel::LEVEL_LOW)).Times(1);
    EXPECT_CALL(mock_gpio, set_level(pin_rinse, hal::GpioLevel::LEVEL_LOW)).Times(1);
    EXPECT_CALL(mock_gpio, set_level(pin_spin, hal::GpioLevel::LEVEL_LOW)).Times(1);
    EXPECT_CALL(mock_gpio, set_level(pin_lvl_low, hal::GpioLevel::LEVEL_LOW)).Times(1);
    EXPECT_CALL(mock_gpio, set_level(pin_lvl_med, hal::GpioLevel::LEVEL_LOW)).Times(1);

    EXPECT_CALL(mock_gpio, set_level(pin_spin, hal::GpioLevel::LEVEL_HIGH)).Times(1);
    EXPECT_CALL(mock_gpio, set_level(pin_softener, hal::GpioLevel::LEVEL_HIGH)).Times(1);

    panel.show_diagnostic(domain::DiagnosticStep::SPIN_TEST, 0x00, false);
}
