aluiziotomazelli/washing-machine/(commit log)

2026-08-31 feat(legacy): v0.1.0 - Initial spaghetti Arduino firmware baseline
2026-08-31 feat(hal): introduce IGpioHAL and ITimerHAL interfaces with Arduino implementations
2026-08-31 feat(ui): add IButton interface and non-blocking Button FSM debouncer
2026-08-31 test: add GoogleMock HAL mocks and Button unit test suite
2026-09-01 docs: add comprehensive case study documentation and link in README
2026-09-01 feat(hal): add IDigitalOutput interface and intrusive DigitalOutput driver with unit tests
2026-09-01 feat(hal): add IReversibleMotor and ReversibleMotor driver with dead-time management and unit tests
2026-09-01 feat(hal): add IWaterLevelSensor interface and PressureSwitchSensor driver with unit tests
2026-09-01 feat(ui): add IBuzzer interface and non-blocking 3kHz Buzzer driver with tone HAL
    [arduino_gpio_hal.cpp, arduino_gpio_hal.hpp, buzzer.cpp, buzzer.hpp, test_buzzer.cpp]
2026-09-01 feat(ui): add ILedPanel interface and DiscreteLedPanel driver with unit tests
2026-09-01 docs: consolidate host unit testing into v0.2.0 and update peripheral drivers in Chapter 4
2026-09-01 refactor: remove legacy libraries directory and wire up modern HAL drivers in sketch
2026-09-01 fix(hal): ensure default high water level pin is 255 to prevent conflict with ledNivelM on pin 12
    [pressure_switch_sensor.hpp]
2026-09-01 docs: add Chapter 5 on domain modeling, SRP and process controllers to case study
2026-09-01 feat: integrate modular wash engine into main Arduino sketch
2026-09-01 fix(ui): fix heavy wash led blinking in idle and make softener click single beep
    [panel_controller.cpp, panel_controller.hpp]
2026-09-01 fix(ui): ensure program LED turns on at boot by not overwriting with idle stage
    [panel_controller.cpp]
2026-09-01 feat(ui): restore legacy visual error differentiation for fill and drain timeouts
    [discrete_led_panel.cpp, discrete_led_panel.hpp, panel_controller.cpp, test_discrete_led_panel.cpp, test_wash_cycle_coordinator.cpp, wash_cycle_coordinator.cpp]
2026-09-01 refactor: update buzzer pattern timings
    [buzzer.cpp, panel_controller.cpp]
2026-09-01 docs: update case study with Chapter 6 for v0.3.0 FSM and Panel orchestration
2026-09-02 feat(hal): implement IRgbStrip interface, zero-heap Ws2812Strip driver and unit tests
2026-09-02 refactor(hal): reorganize ATmega328P pinout for LED strip, I2C bus and ribbon cable layout
2026-09-02 fix(ui): invert WS2812 pixel indices to match physical right-to-left strip orientation
    [strip_led_panel.hpp, test_strip_led_panel.cpp]
2026-09-02 fix(ui): throttle strip to 30 FPS, pause frames during buzzer, and wake up to IDLE from FINISHED
    [panel_controller.cpp, pinout.hpp, strip_led_panel.hpp, test_panel_controller.cpp]
2026-09-02 fix(ui): add constructors to ButtonConfig and StripLedConfig to allow brace-initialization in Clang/C++11
    [button.cpp, strip_led_panel.hpp, washing-machine.ino]
2026-09-02 style(ui): desaturate softener pink to pastel rose and tune button timings
2026-09-02 docs: add Chapter 7 to case-study detailing WS2812 strip driver, hardware re-spin, and AVR interrupt collision
2026-09-02 fix(fsm): eliminate pump toggle glitch in drain-to-spin handover and skip empty drain
    [drain_controller.cpp, drain_controller.hpp, test_drain_controller.cpp, test_wash_cycle_coordinator.cpp, wash_cycle_coordinator.cpp, wash_cycle_coordinator.hpp]
2026-09-02 feat(hal): implement AVR hardware watchdog timer with early init protection
2026-09-02 fix(app): remove private coordinator trigger_error call in setup
    [washing-machine.ino]
2026-09-02 feat(hal): implement II2cHAL, ArduinoI2cHAL, and Mpu6050 accelerometer driver with tests
2026-09-03 docs: add vibration telemetry analysis and empirical spin logs
    - Record and document 5 physical spin test runs across low and medium levels,
    evaluating empty basket, light asymmetric loads, and heavy concentrated loads.
    - Capture empirical walking threshold at peak 15417 LSB (dynamic foot slip
    with vertical normal force reduction to 0.72g and 6706 LSB lateral force).
    - Add scripts/record_telemetry.py with DTR reset mitigation and English CLI.
    - Consolidate findings, sensor placement rationale, and empirical threshold
    calibration zones into docs/vibration_analysis.md.
    [test1_empty_tub_low_level.csv, test2_empty_tub_medium_level.csv, test3_unbalanced_light_blanket_medium_level.csv, test4_unbalanced_light_blanket_low_level.csv, test5_unbalanced_heavy_blanket_medium_level.csv]
2026-09-03 feat(spin): implement tailored progressive sprint schedule and log test runs
    - Introduce SprintStep structure to pair tailored motor run (ON) and drain
    pause (OFF) durations per sprint stage.
    - Eliminate deceleration resonance by tuning S2 pause from 5.0s to 3.5s.
    - Calibrate final sequence: S1 (4s/3.5s), S2 (5s/3.5s), S3 (6s/4s), S4 (7s/3s).
    - Verify peak vibration reduction on empty basket from 5526 down to 3729 (32.5%),
    and on unbalanced load from 12840 down to 5005 (61.0%).
    - Record test runs 6 through 10 and document deceleration dynamics in
    docs/vibration_analysis.md.
    [test10_finetuned_sprint_empty_tub.csv, test6_new_sprint_unbalanced_light_blanket.csv, test7_shorter_sprint_unbalanced_light_blanket.csv, test8_tailored_sprint_steps_unbalanced_light_blanket.csv, test9_finetuned_sprint_steps_unbalanced_light_blanket.csv]
2026-09-03 docs: add test 11 telemetry demonstrating walking prevention with fine-tuned ramp
    - Add test 11 log retesting the heavy folded blanket with the calibrated sprint profile.
    - Record peak reduction from 15417 down to 11865 (-23%) with zero samples exceeding 14000.
    - Confirm cabinet stayed in place with no walking or foot displacement.
    - Update scripts/record_telemetry.py with resilient serial reconnect logic.
    [test11_finetuned_sprint_unbalanced_heavy_blanket.csv]
2026-09-03 feat: implement VibrationMonitor and dynamic unbalance retry in SpinController
    - Add IVibrationMonitor interface and VibrationMonitor controller class.
    - Implement 200 ms rolling peak-to-peak envelope calculation with gravity DC offset rejection.
    - Support configurable unbalance detection thresholds (motion, warning, sustained trip, and instant shock).
    - Integrate IVibrationMonitor with SpinController including null pointer safety.
    - Add RETRY_COASTING state and max_unbalance_retries configuration to SpinConfig.
    - Implement automatic spin recovery: coast down to 0 RPM with pump on, reset monitor, and re-engage progressive ramp from sprint 1.
    - Add UNBALANCED_LOAD to MachineError when retries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
    [spin_controller.cpp, spin_controller.hpp, test_spin_controller.cpp, test_vibration_monitor.cpp, vibration_monitor.cpp]
2026-09-03 feat: support cycle resumption from error states across controllers and UI
    - Add reset_error methods to FillController, DrainController, and SpinController.
    - Add handover method to DrainController for seamless transition to spin without shutting off pump.
    - Enable WashCycleCoordinator::resume_cycle to clear controller errors and re-execute current step while preserving cycle recipe and settings.
    - Enable WashCycleCoordinator::update to latch UNBALANCED_LOAD when SpinController retries are exhausted.
    - Update PanelController to allow resuming or canceling cycle from error via start/pause button.
    - Render UNBALANCED_LOAD error on strip and discrete LED panels by blinking spin indicator.
    - Add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
    [discrete_led_panel.cpp, drain_controller.hpp, fill_controller.hpp, panel_controller.cpp, spin_controller.cpp, spin_controller.hpp, strip_led_panel.cpp, test_discrete_led_panel.cpp]
2026-09-03 feat: implement hydraulic unbalance recovery sub-cycle in wash coordinator
    - Add RECOVERY_FILL, RECOVERY_AGITATE, and RECOVERY_DRAIN steps to CycleStep.
    - Add max_unbalance_recoveries, unbalance_agitate_sec, and unbalance_fill_level to CoordinatorConfig.
    - Intercept spin controller unbalance error to execute hydraulic redistribution sub-routine before latching error.
    - Restore spin step and reset spin controller error upon completing hydraulic drain.
    - Add unit tests validating hydraulic recovery sequence, retry exhaustion, and disabled recovery configuration.
    [test_wash_cycle_coordinator.cpp, wash_cycle_coordinator.cpp, wash_cycle_coordinator.hpp]
2026-09-03 docs: add Chapter 8 to case-study detailing watchdog, MPU-6050, and unbalance recovery
    - Document AVR hardware watchdog and early .init3 disable to prevent Optiboot boot loops.
    - Detail zero-allocation MPU-6050 accelerometer driver on liberated I2C bus.
    - Explain drum resonance mechanics, empirical telemetry, and progressive sprint ramp.
    - Detail VibrationMonitor rolling peak-to-peak math and intrinsic static gravity cancellation.
    - Document two-tier unbalance recovery across SpinController and WashCycleCoordinator.
    - Update milestone metrics table reflecting 138 unit tests and v0.5.0 memory footprint.
2026-09-03 feat: wire VibrationMonitor into SpinController and update v0.5.0 memory metrics
    - Connect VibrationMonitor instance to SpinController in sketch setup.
    - Clean up live telemetry loop to use VibrationMonitor peak-to-peak and sample getters.
    - Update v0.5.0 Flash ROM and SRAM metrics in case-study.md to reflect final binary footprint (22,120 B Flash, 1,383 B SRAM).
    [washing-machine.ino]
2026-09-03 docs: clarify motor stall and TRIAC thermal stress on simultaneous energization in case-study
2026-09-03 docs: update case study documentation and refine spin controller logic
2026-09-03 fix: reset vibration monitor and restart sprint sequence upon resuming spin controller
    [spin_controller.cpp, test_spin_controller.cpp]
2026-09-05 refactor: update wash program sequence, adjust LED panel layout and styling
2026-09-05 feat: implement field service diagnostic controller and technical manual (v0.6.0)
    - Add DiagnosticController with 7-step hardware self-test routine
    - Support isolated testing of valves, pump, motor agitation, and spin
    - Integrate MPU-6050 vibration telemetry with dynamic VU-meter on LED strip
    - Implement 5-second clutch delay interlock and active unbalance trip
    - Provide dual-panel visual feedback (StripLedPanel and DiscreteLedPanel)
    - Add comprehensive Field Service & Diagnostic Manual in docs/technical-manual.md
    - Update docs/case-study.md and README.md with v0.6.0 milestones and 169 unit tests
    [diagnostic_controller.cpp, diagnostic_controller.hpp, discrete_led_panel.cpp, discrete_led_panel.hpp, panel_controller.cpp, panel_controller.hpp]
2026-09-05 fix(sensor): add connection health tracking and i2c auto-detection for vibration sensor
    [arduino_i2c_hal.cpp, diagnostic_controller.cpp, mpu6050.cpp, mpu6050.hpp, test_diagnostic_controller.cpp, test_mpu6050.cpp]
2026-09-05 fix(spin): enforce complete coast-down and pump shutdown before hydraulic recovery handover
    [spin_controller.cpp, test_spin_controller.cpp, test_wash_cycle_coordinator.cpp, wash_cycle_coordinator.cpp]
2026-09-05 fix(diagnostic): prevent buzzer tone glitching by pausing WS2812 show while audio is playing
    [diagnostic_controller.cpp, test_diagnostic_controller.cpp]
2026-09-06 feat(fsm): add intermediate spin at the end of wash stage and unify intermediate spin timing
2026-09-06 fix(fill): increase default fill timeout to 20 minutes
    [fill_controller.hpp]
2026-09-06 feat(hal): introduce IEepromHAL abstraction, Arduino driver and mock test suite
2026-09-06 feat(persistence): implement wear-leveling EEPROM cycle persistence and power-loss recovery
    - Add IEepromHAL abstraction with AVR EEPROM driver and MockEepromHAL
    - Add ICyclePersistence interface and CyclePersistenceManager implementation
    - Implement 64-slot circular ring buffer with CRC-8 and monotonic sequence scanning
    - Support automatic power outage resumption for active and paused states
    - Restore user program/level preferences on boot without writes on idle button browsing
    - Add COUNT sentinels to WashProgram and WaterLevel enums for future-proof validation
    - Expand GoogleTest unit test suite to 198 tests with 100% pass rate
2026-09-06 docs: add EEPROM persistence chapter to case-study and update README
2026-09-06 docs: clarify last used program preference in case-study
2026-09-06 fix(ui): synchronize stage LED presentation when booting directly into paused state
    [panel_controller.cpp, test_panel_controller.cpp]
2026-09-06 fix(diag): reset vibration monitor on diagnostic step transitions and spin toggles
    [diagnostic_controller.cpp, test_diagnostic_controller.cpp]
2026-09-06 feat: optimize dual-valve filling, reduce drain bleed, and plan linear level sensor
2026-09-08 docs: integrate balance ring tuning documentation, datasets and tuned sprint profile
    [test_00_base.csv, test_01_plus50ml.csv, test_02_plus100ml.csv, test_03_plus150ml.csv, test_04_plus200ml.csv, test_05_plus250ml.csv, test_06_plus300ml.csv, test_07_almost-balanced-load_plus250ml.csv]
2026-09-08 fix(fsm): handle spin coast-down during advance and pause
    [spin_controller.cpp, test_spin_controller.cpp, test_wash_cycle_coordinator.cpp, wash_cycle_coordinator.cpp]
2026-11-02 docs(ui): credit Michel Deslierres for button FSM state machine architecture
